ArthorH/MMS2-F405/PCB-source/IMG/PINOUT_ROWC.PNG

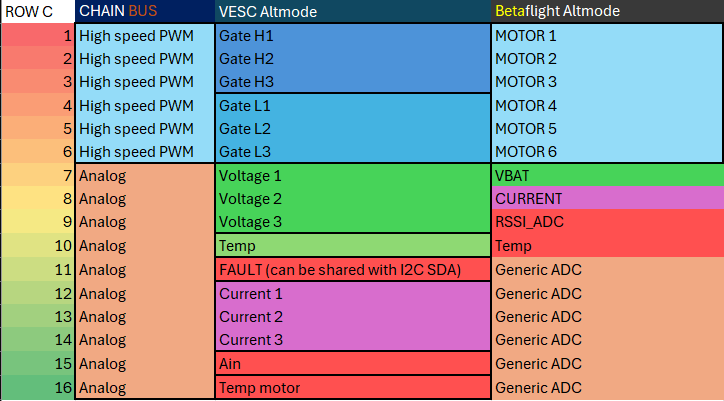
PCB-source/IMG/PINOUT_ROWC.PNG
