ArthorH/MMS2-F405/PCB-source/IMG/PINOUT_ROWA.PNG

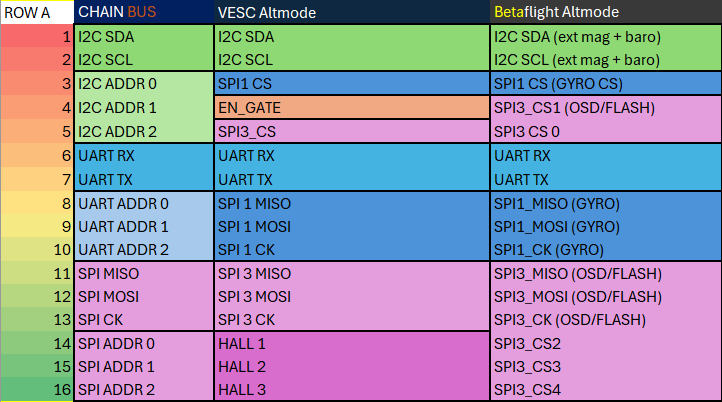
PCB-source/IMG/PINOUT_ROWA.PNG
