ArthorH/MMS2-F405/Doc/Chainbus-Pinout-Specification.xlsx

 | CHAINBUS CONNECTOR
ROW A IS DEDICATED FOR STACKABLE SOLUTION BUT ALSO CAN WORK IN ALTMODE |  |  |  |  |  |  | STM32F405RGT6 | STM32H563VGT6
ROW A pin | Num | CHAIN BUS | VESC Altmode | Betaflight Altmode | STM32F405RGT6 | STM32H563VGT6 | PA12
1 | 6 | UART RX | UART RX | UART RX | PC11 (UART4 RX) |  | PA11
2 | 7 | UART TX | UART TX | UART TX | PC10 (UART4 TX) |  | PB9
3 | 8 | UART ADDR 0 | SPI 1 MISO | SPI1_MISO (GYRO) | PA6 (SPI 1) (GPIO) |  | PB8
4 | 9 | UART ADDR 1 | SPI 1 MOSI | SPI1_MOSI (GYRO) | PA7 (SPI 1) (GPIO) |  | PB6
5 | 10 | UART ADDR 2 | SPI 1 CK | SPI1_CK (GYRO) | PA5 (SPI 1) (GPIO) |  | PB13
6 | 11 | SPI MISO | SPI 3 MISO | SPI3_MISO (OSD/FLASH) | PB4 (SPI3) (GPIO)
7 | 12 | SPI MOSI | SPI 3 MOSI | SPI3_MOSI (OSD/FLASH) | PC12 (SPI3) (GPIO)
8 | 13 | SPI CK | SPI 3 CK | SPI3_CK (OSD/FLASH) | PB3 (SPI3) (GPIO)
 | 14 | SPI ADDR 0 | HALL 1 | SPI3_CS2 | PC6 (SPI3_CS) (GPIO)
10 | 15 | SPI ADDR 1 | HALL 2 | SPI3_CS3 | PC7 (SPI3_CS) (GPIO)
11 | 16 | SPI ADDR 2 | HALL 3 | SPI3_CS4 | PC8 (SPI3_CS) (GPIO)
12 | 3 | I2C ADDR 0 | SPI1 CS | SPI1 CS (GYRO CS) | PA15 (SPI1_CS) (GPIO)
13 | 4 | I2C ADDR 1 | EN_GATE | SPI3_CS1 (OSD/FLASH) | PB5 (SPI3 CS) (EN)
14 | 5 | I2C ADDR 2 | SPI3_CS | SPI3 CS 0 | PC9 (SPI3 CS) (GPIO)
16 | 2 | I2C SCL | I2C SCL | I2C SCL (ext mag + baro) | PB10 (I2C 2)
15 | 1 | I2C SDA | I2C SDA | I2C SDA (ext mag + baro) | PB11 (I2C 2)
ROW C IS DEDICATED ALTMODE HEADER MOSTLY FOR ANALOG
ROW C pin | Num | CHAIN BUS | VESC Altmode | Betaflight Altmode | STM32F405RGT6 | STM32H563VGT6
1 | 1 | High speed PWM | Gate H1 | MOTOR 1 | PA8 (TIM CH)
2 | 2 | High speed PWM | Gate H2 | MOTOR 2 | PA9 (TIM CH)
3 | 3 | High speed PWM | Gate H3 | MOTOR 3 | PA10 (TIM CH)
4 | 4 | High speed PWM | Gate L1 | MOTOR 4 | PB13 (TIM CH)
5 | 5 | High speed PWM | Gate L2 | MOTOR 5 | PB14 (TIM CH)
6 | 6 | High speed PWM | Gate L3 | MOTOR 6 | PB15 (TIM CH)
7 | 11 | Analog | FAULT (can be shared with I2C SDA) | Generic ADC | PB7 (ADC IN)
8 | 12 | Analog | Current 1 | Generic ADC | PC0 (ADC IN)
9 | 13 | Analog | Current 2 | Generic ADC | PC1 (ADC IN)
10 | 14 | Analog | Current 3 | Generic ADC | PC2 (ADC IN)
11 | 15 | Analog | Ain | Generic ADC | PC3 (ADC IN)
12 | 7 | Analog | Voltage 1 | VBAT | PA0 (ADC IN)
13 | 8 | Analog | Voltage 2 | CURRENT | PA1 (ADC IN)
14 | 9 | Analog | Voltage 3 | RSSI_ADC | PA2 (ADC IN)
15 | 10 | Analog | Temp | Temp | PA3 (ADC IN)
16 | 16 | Analog | Temp motor | Generic ADC | PC4 (ADC IN)
 | ROW C IS DEDICATED ALTMODE HEADER MOSTLY FOR ANALOG
 | ROW B | MMS | Rating | Note | Powa
 | 1 | 3V3 | 1A max | MMS Output only | 3.3W
 | 2 | 5V | 1A max | MMS Output only | 5W
 | 3 | GND | 1A (5V and 3v3) return | Bidir | Return 8.3W
 | 4 | Vbat | 5v - 60v Vin | Bidir | 40W - 480W
 | 5 | Vbat | 5v - 60v Vin | Bidir
 | 6 | Vbat | 5v - 60v Vin | Bidir
 | 7 | Vbat | 5v - 60v Vin | Bidir
 | 8 | GND | 2A return | Bidir | Return 40W - 480W
 | 9 | GND | 2A return | Bidir
 | 10 | GND | 2A return | Bidir
 | 11 | GND | 2A return | Bidir
 | 12 | Reserved | N/A | N/A | N/A
 | 13 | Reserved | N/A | N/A | N/A
 | 14 | Reserved | N/A | N/A | N/A
 | 15 | Reserved | N/A | N/A | N/A
 | 16 | Reserved | N/A | N/A | N/A
VESC: — the VESC firmware uses the H1/H2/H3/L1/L2/L3 PWM channels and typical ADCs for current/vbat; AS5048 on SPI1 with PB3 CS is straightforward to configure in VESC (select the CS pin in hardware config).
Betaflight: once you resource-map the pins you chose (serial on PB11/PB10, SPI1 on PA5/6/7 with CS on PB3, SPI3 on PC10/11/12 with CS lines on PC9/PC6/PC7/PC8, motors on PA8/PA9/PA10/PB13-15, ADCs on PA0/1/2), Betaflight can be made to work. You will need to set resource commands.
