ArthorH/MMS2-F405/Doc/MMS2_QR.PNG

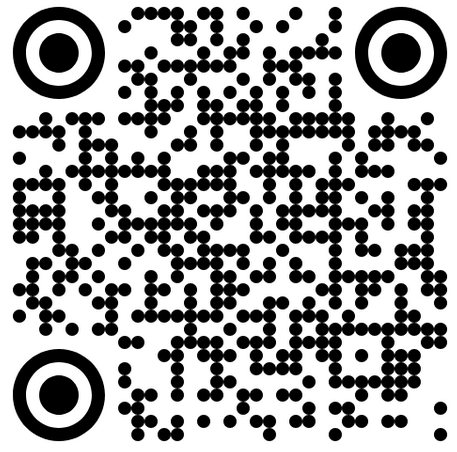
Doc/MMS2_QR.PNG
