ArthorH/MMS2-F405/PCB-source/IMG/999x999-product_41021_41021037_41021037-1.jpg

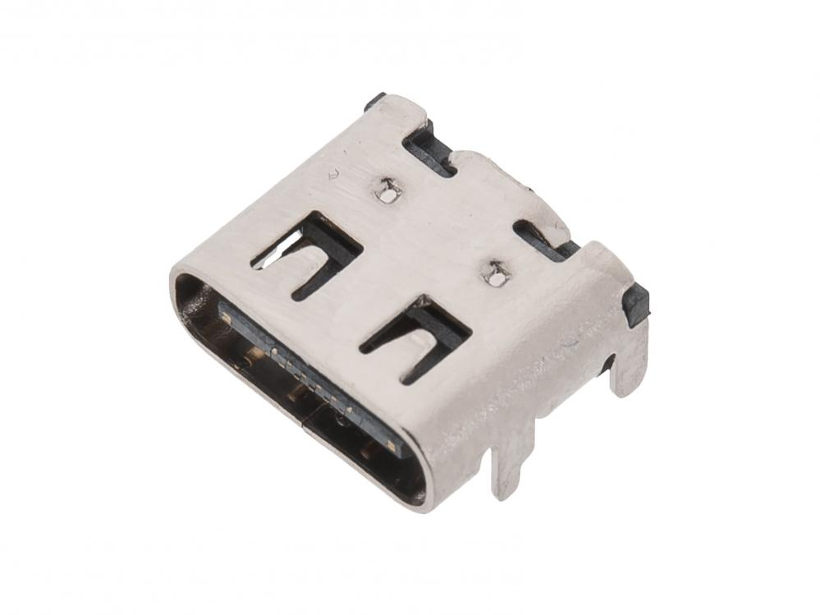
PCB-source/IMG/999x999-product_41021_41021037_41021037-1.jpg
