ArthorH/MMS2-F405/PCB-source/IMG/amass-XT60PW-M_l.jpg

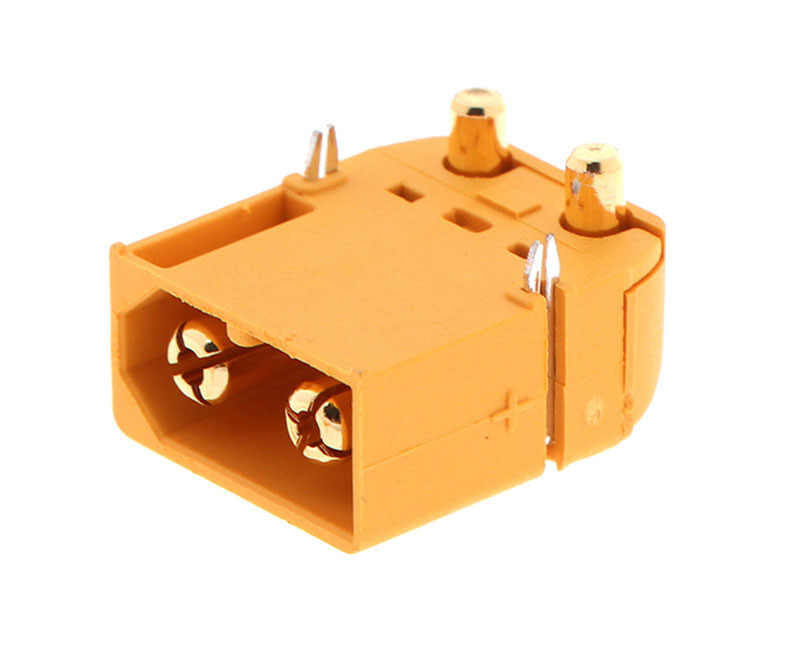
PCB-source/IMG/amass-XT60PW-M_l.jpg
