ArthorH/MMS2-F405/PCB-source/IMG/Capture.PNG

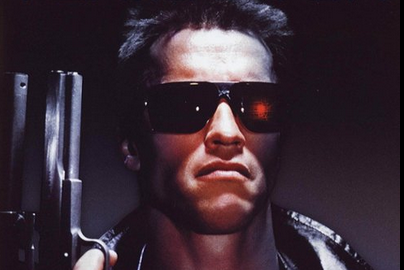
PCB-source/IMG/Capture.PNG
