ArthorH/MMS2-F405/PCB-source/IMG/images.jpg

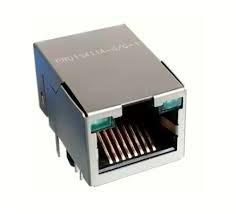
PCB-source/IMG/images.jpg
