ArthorH/MMS2-F405/PCB-source/IMG/Pcb spacer.PNG

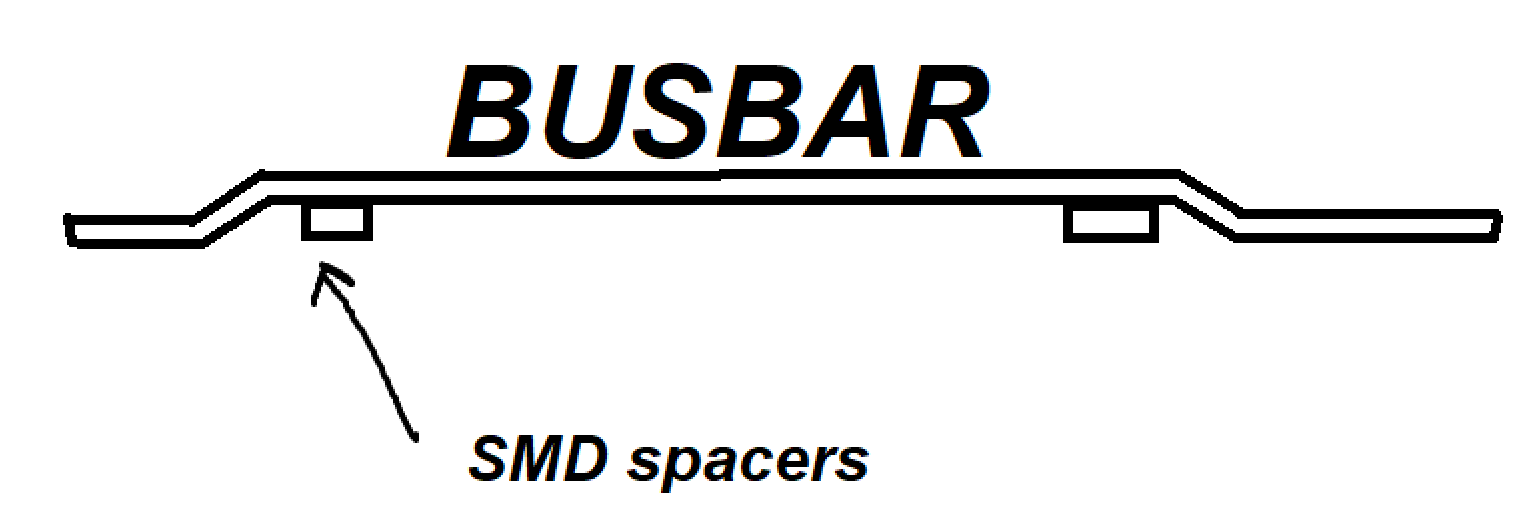
PCB-source/IMG/Pcb spacer.PNG
