ArthorH/MMS2-F405/PCB-source/IMG/USBimpedance.PNG

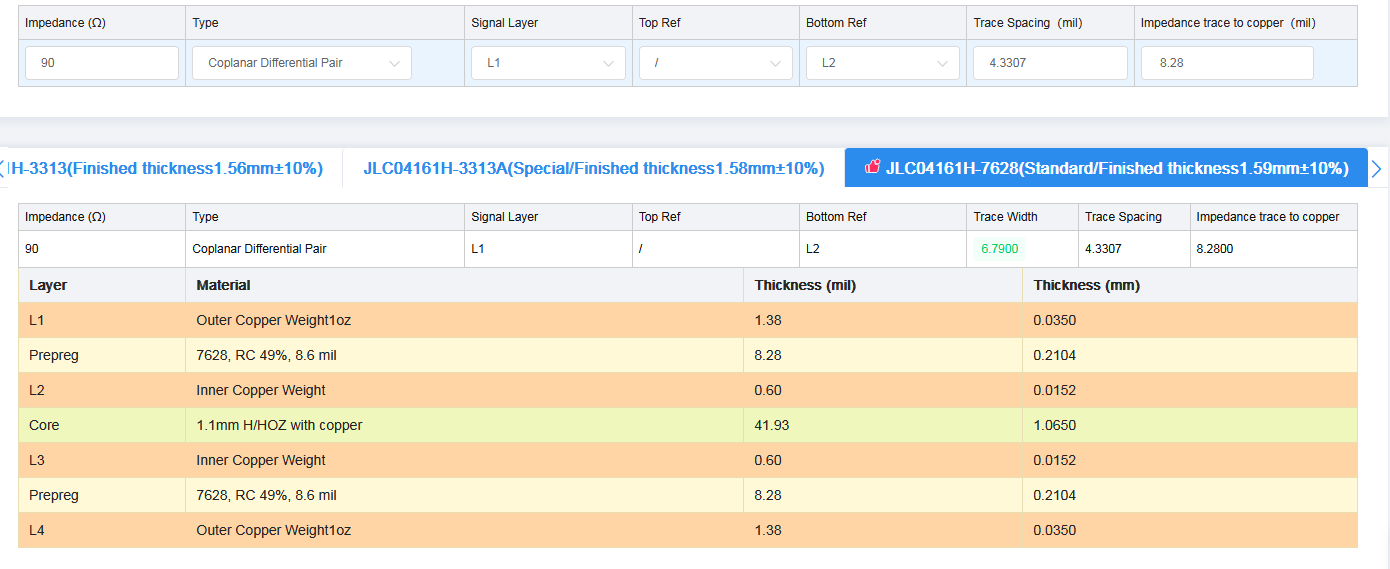
PCB-source/IMG/USBimpedance.PNG
