ArthorH/MMS2-F405/PCB-source/MMS2.kicad_pcb

## KiCad design PCB-source/MMS2.kicad_pcb (2025-09-29)

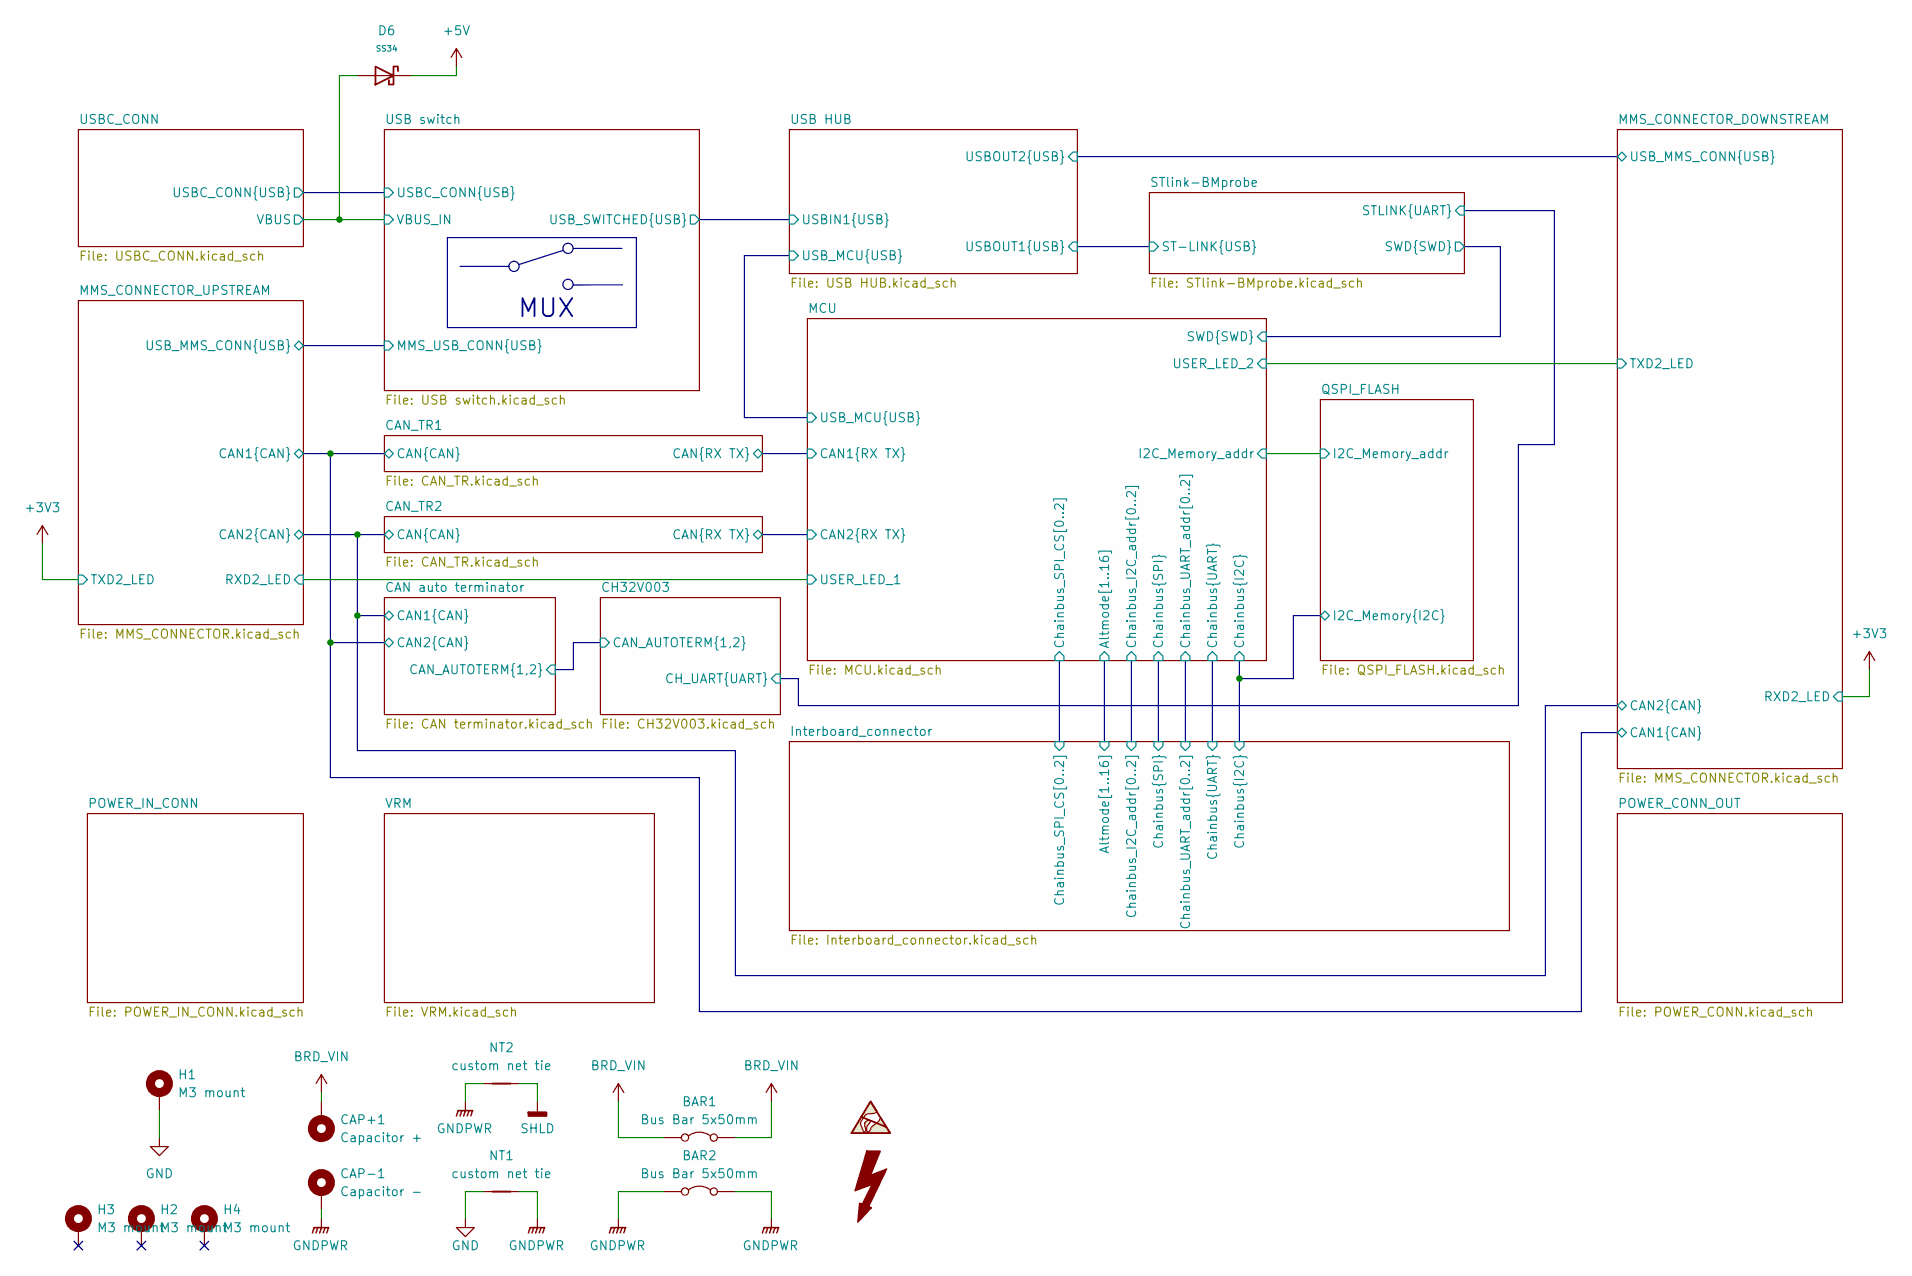
[picture p10: schematic MMS2.kicad_sch]

Parts:
BAR1: Bus Bar 5x50mm; BusBar-50mm-Red
BAR2: Bus Bar 5x50mm; BusBar-50mm-black
CAP+1: Capacitor +; TestPoint_THTPad_1.5x1.5mm_Drill0.7mm
CAP-1: Capacitor -; TestPoint_THTPad_1.5x1.5mm_Drill0.7mm
D6: SS34; D_SMA; Forward Voltage (Vf@If) 550mV@3A; Reverse Voltage (Vr) 40V; Part SS34; LCSC C8678
H1, H2: M3 mount; MountingHole_3.2mm_M3_DIN965_Pad
H3, H4: M3 mount; MountingHole_3.2mm_M3_DIN965_Pad; LCSC C49236535
NT1: custom net tie; Custom
NT2: custom net tie; SHLD

Connections:
+5V: D6.1; also elsewhere on the board
BRD_VIN: BAR1.1 (A), BAR1.2 (B), CAP+1.1; also elsewhere on the board
GND: H1.1, NT1.1; also elsewhere on the board
GNDPWR: BAR2.1 (A), BAR2.2 (B), CAP-1.1, NT1.2, NT2.1; also elsewhere on the board
SHLD: NT2.2
VBUS: D6.2; also elsewhere on the board

Notes on the sheet:
MUX

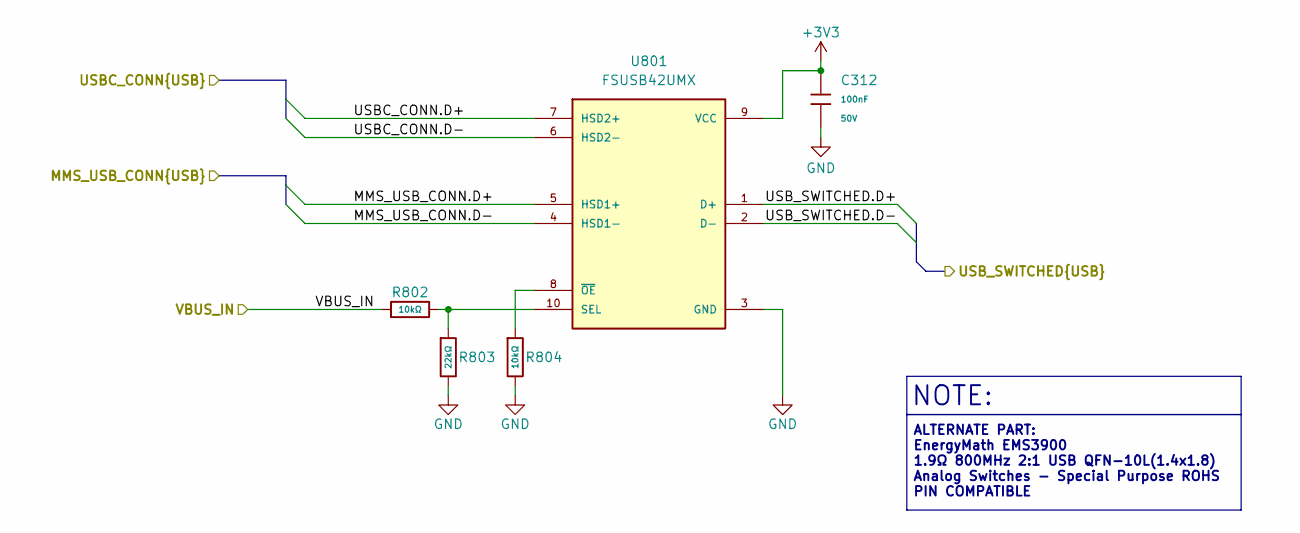
[picture p11: schematic USB switch.kicad_sch]

Parts:
C312: 100nF; C_0402; Voltage Rated 50V; Tolerance ±10%; Part CL05B104KB54PNC; LCSC C307331
R802, R804: 10kΩ; R_0402; Overload Voltage (Max) 50V; Tolerance ±1%; Part 0402WGF1002TCE; LCSC C25744
R803: 22kΩ; R_0402; Overload Voltage (Max) 50V; Tolerance ±1%; Part 0402WGF2202TCE; LCSC C25768
U801: FSUSB42UMX; UFQFN-10_1.4x1.8; PARTREV 1.25; LCSC C11145

Connections:
+3V3: C312.1, U801.9 (VCC); also elsewhere on the board
/MMS_CONNECTOR_UPSTREAM/USB_MMS_CONN.D+: U801.5 (HSD1+); also elsewhere on the board
/MMS_CONNECTOR_UPSTREAM/USB_MMS_CONN.D-: U801.4 (HSD1-); also elsewhere on the board
/USB HUB/USBIN1.D+: U801.1 (D+); also elsewhere on the board
/USB HUB/USBIN1.D-: U801.2 (D-); also elsewhere on the board
/USB switch/USBC_CONN.D+: U801.7 (HSD2+); also elsewhere on the board
/USB switch/USBC_CONN.D-: U801.6 (HSD2-); also elsewhere on the board
GND: C312.2, R803.2, R804.2, U801.3 (GND); also elsewhere on the board
unnamed: R802.2, R803.1, U801.10 (SEL)
unnamed: R804.1, U801.8 (~OE)
VBUS: R802.1; also elsewhere on the board

Notes on the sheet:
NOTE:
ALTERNATE PART: EnergyMath EMS3900 1.9Ω 800MHz 2:1 USB QFN-10L(1.4x1.8) Analog Switches - Special Purpose ROHS PIN COMPATIBLE

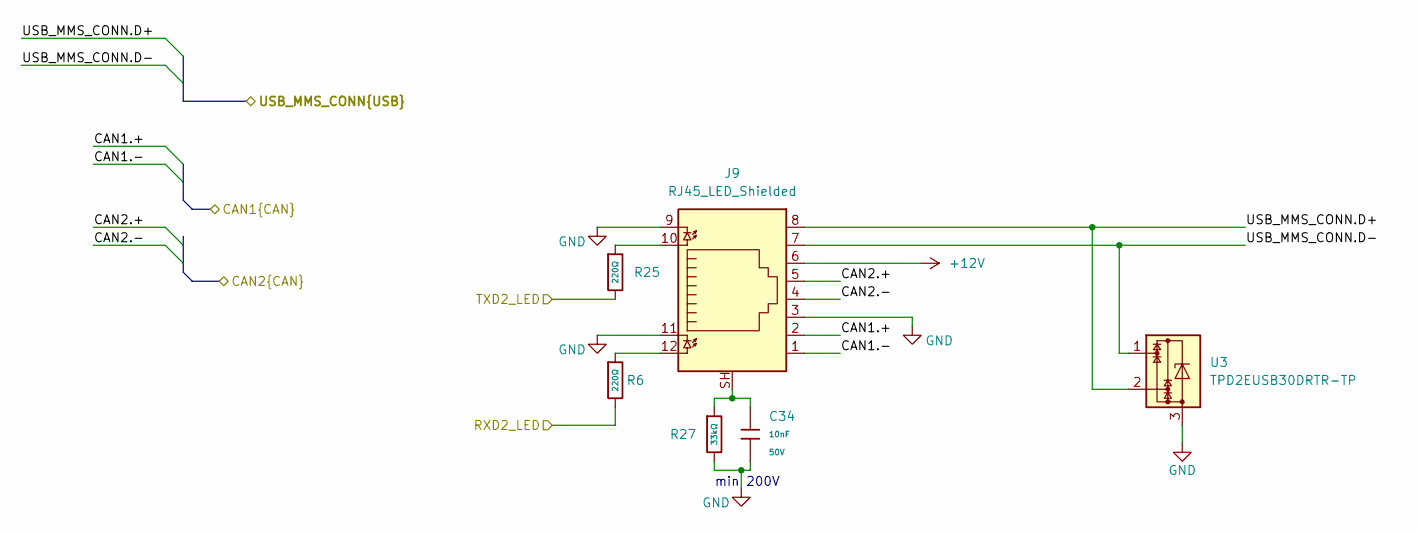
[picture p12: schematic MMS_CONNECTOR.kicad_sch, Mini moducard connector]

Parts:
C34: 10nF; C_0402; Voltage Rated 50V; Tolerance ±10%; Part CL05B103KB5NNNC; LCSC C15195
J9: RJ45_LED_Shielded; RJ45_Amphenol_RJHSE538X
R6, R25: 220Ω; R_0402; Overload Voltage (Max) 50V; Tolerance ±1%; Part 0402WGF2200TCE; LCSC C25091
R27: 33kΩ; R_0402; Overload Voltage (Max) 50V; Tolerance ±1%; Part 0402WGF3302TCE; LCSC C25779
U3: TPD2EUSB30DRTR-TP; SOT-723; LCSC C2844720

Connections:
+3V3: R6.2; also elsewhere on the board
+12V: J9.6; also elsewhere on the board
/CAN auto terminator/CAN1.+: J9.5; also elsewhere on the board
/CAN auto terminator/CAN1.-: J9.4; also elsewhere on the board
/CAN auto terminator/CAN2.+: J9.2; also elsewhere on the board
/CAN auto terminator/CAN2.-: J9.1; also elsewhere on the board
/MCU/USER_LED_2: R25.2; also elsewhere on the board
/MMS_CONNECTOR_DOWNSTREAM/USB_MMS_CONN.D+: J9.8, U3.2; also elsewhere on the board
/MMS_CONNECTOR_DOWNSTREAM/USB_MMS_CONN.D-: J9.7, U3.1; also elsewhere on the board
GND: C34.2, J9.3, J9.9, J9.11, R27.2, U3.3; also elsewhere on the board
unnamed: C34.1, J9.SH, R27.1
unnamed: J9.10, R25.1
unnamed: J9.12, R6.1

Parts of its further copies:
C45: 10nF; C_0402; Voltage Rated 50V; Tolerance ±10%; Part CL05B103KB5NNNC; LCSC C15195
J8: RJ45_LED_Shielded; RJ45_Amphenol_RJHSE538X
R26, R53: 220Ω; R_0402; Overload Voltage (Max) 50V; Tolerance ±1%; Part 0402WGF2200TCE; LCSC C25091
R51: 33kΩ; R_0402; Overload Voltage (Max) 50V; Tolerance ±1%; Part 0402WGF3302TCE; LCSC C25779
U4: TPD2EUSB30DRTR-TP; SOT-723; LCSC C2844720

Connections of its further copies:
+3V3: R26.2; also elsewhere on the board
+12V: J8.6; also elsewhere on the board
/CAN auto terminator/CAN1.+: J8.5; also elsewhere on the board
/CAN auto terminator/CAN1.-: J8.4; also elsewhere on the board
/CAN auto terminator/CAN2.+: J8.2; also elsewhere on the board
/CAN auto terminator/CAN2.-: J8.1; also elsewhere on the board
/MCU/USER_LED_1: R53.2; also elsewhere on the board
/MMS_CONNECTOR_UPSTREAM/USB_MMS_CONN.D+: J8.8, U4.2; also elsewhere on the board
/MMS_CONNECTOR_UPSTREAM/USB_MMS_CONN.D-: J8.7, U4.1; also elsewhere on the board
GND: C45.2, J8.3, J8.9, J8.11, R51.2, U4.3; also elsewhere on the board
unnamed: C45.1, J8.SH, R51.1
unnamed: J8.10, R26.1
unnamed: J8.12, R53.1

Notes on the sheet:
min 200V

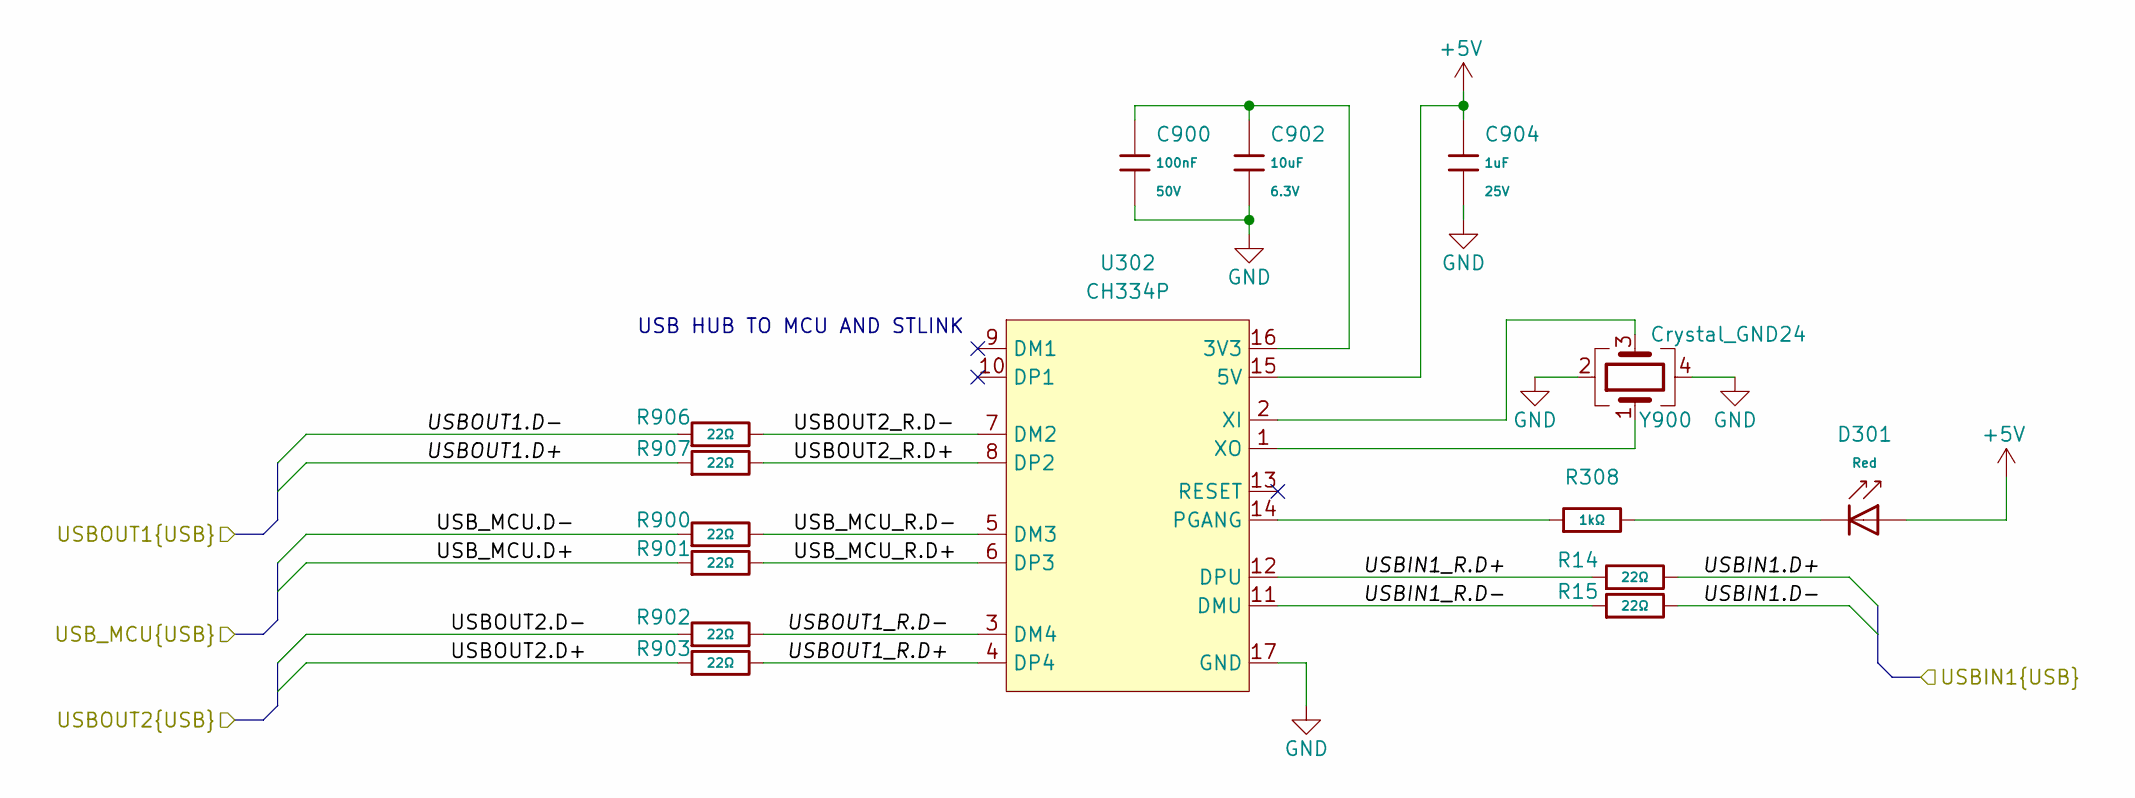
[picture p13: schematic USB HUB.kicad_sch, MMS2]

Parts:
C900: 100nF; C_0402; Voltage Rated 50V; Tolerance ±10%; Part CL05B104KB54PNC; LCSC C307331
C902: 10uF; C_0402; Voltage Rated 6.3V; Tolerance ±20%; Part CL05A106MQ5NUNC; LCSC C15525
C904: 1uF; C_0402; Voltage Rated 25V; Tolerance ±10%; Part CL05A105KA5NQNC; LCSC C52923
D301: Red; D_0603; Part KT-0603R; LCSC C2286
R14, R15, R900, R901, R902, R903, R906, R907: 22Ω; R_0402; Overload Voltage (Max) 50V; Tolerance ±1%; Part 0402WGF220JTCE; LCSC C25092
R308: 1kΩ; R_0402; Overload Voltage (Max) 50V; Tolerance ±1%; Part 0402WGF1001TCE; LCSC C11702
U302: CH334P; QFN-16-1EP_3x3mm_P0.5mm_EP1.7x1.7mm
Y900: Crystal_GND24; Crystal_SMD_3225-4Pin_3.2x2.5mm; LCSC C9002

Connections:
+5V: C904.1, D301.2, U302.15 (5V); also elsewhere on the board
/MCU/USB_MCU.D+: R901.1; also elsewhere on the board
/MCU/USB_MCU.D-: R900.1; also elsewhere on the board
/MMS_CONNECTOR_DOWNSTREAM/USB_MMS_CONN.D+: R903.1; also elsewhere on the board
/MMS_CONNECTOR_DOWNSTREAM/USB_MMS_CONN.D-: R902.1; also elsewhere on the board
/STlink-BMprobe/ST-LINK.D+: R907.1; also elsewhere on the board
/STlink-BMprobe/ST-LINK.D-: R906.1; also elsewhere on the board
/USB HUB/USBIN1.D+: R14.2; also elsewhere on the board
/USB HUB/USBIN1.D-: R15.2; also elsewhere on the board
/USB HUB/USBIN1_R.D+: R14.1, U302.12 (DPU)
/USB HUB/USBIN1_R.D-: R15.1, U302.11 (DMU)
/USB HUB/USBOUT1_R.D+: R903.2, U302.4 (DP4)
/USB HUB/USBOUT1_R.D-: R902.2, U302.3 (DM4)
/USB HUB/USBOUT2_R.D+: R907.2, U302.8 (DP2)
/USB HUB/USBOUT2_R.D-: R906.2, U302.7 (DM2)
/USB HUB/USB_MCU_R.D+: R901.2, U302.6 (DP3)
/USB HUB/USB_MCU_R.D-: R900.2, U302.5 (DM3)
GND: C900.2, C902.2, C904.2, U302.17 (GND), Y900.2, Y900.4; also elsewhere on the board
unnamed: D301.1, R308.2
unnamed: C900.1, C902.1, U302.16 (3V3)
unnamed: R308.1, U302.14 (PGANG)
unnamed: U302.2 (XI), Y900.3
unnamed: U302.1 (XO), Y900.1

Notes on the sheet:
USB HUB TO MCU AND STLINK

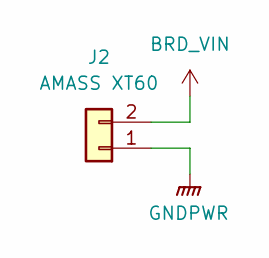
[picture p14: schematic POWER_IN_CONN.kicad_sch]

Parts:
J2: AMASS XT60; AMASS_XT60PW-M_1x02_P7.20mm_Horizontal; LCSC C98732

Connections:
BRD_VIN: J2.2; also elsewhere on the board
GNDPWR: J2.1; also elsewhere on the board

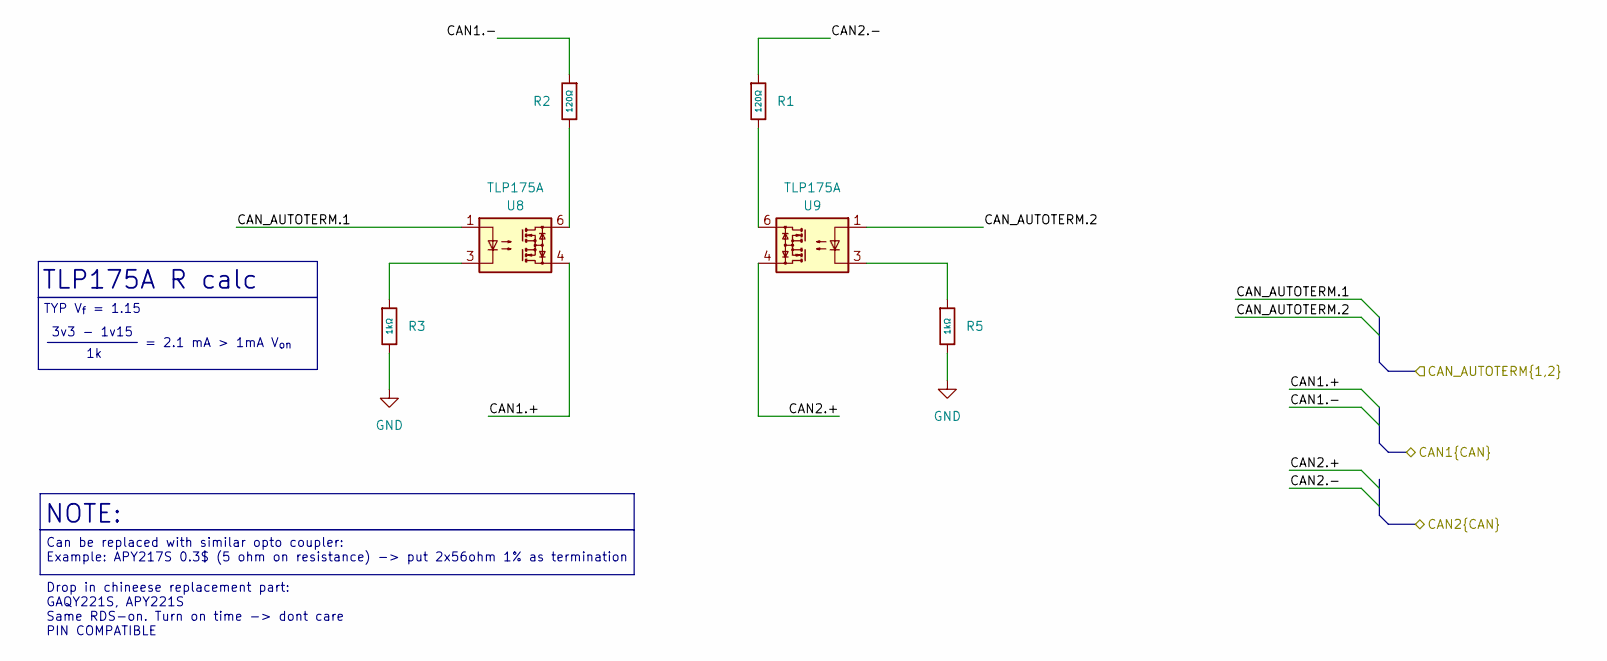
[picture p15: schematic CAN terminator.kicad_sch, CAN Auto terminator]

Parts:
R1, R2: 120Ω; R_0402; Overload Voltage (Max) 50V; Tolerance ±1%; Part 0402WGF1200TCE; LCSC C25079
R3, R5: 1kΩ; R_0402; Overload Voltage (Max) 50V; Tolerance ±1%; Part 0402WGF1001TCE; LCSC C11702
U8, U9: TLP175A; Toshiba_SOIC-4-6_4.4x3.6mm_P1.27mm; LCSC C141522

Connections:
/CAN auto terminator/CAN1.+: U8.4; also elsewhere on the board
/CAN auto terminator/CAN1.-: R2.1; also elsewhere on the board
/CAN auto terminator/CAN2.+: U9.4; also elsewhere on the board
/CAN auto terminator/CAN2.-: R1.1; also elsewhere on the board
/CAN auto terminator/CAN_AUTOTERM.1: U8.1; also elsewhere on the board
/CAN auto terminator/CAN_AUTOTERM.2: U9.1; also elsewhere on the board
GND: R3.2, R5.2; also elsewhere on the board
unnamed: R1.2, U9.6
unnamed: R2.2, U8.6
unnamed: R3.1, U8.3
unnamed: R5.1, U9.3

Notes on the sheet:
TYP V_{f} = 1.15
Can be replaced with similar opto coupler: Example: APY217S 0.3$ (5 ohm on resistance) -> put 2x56ohm 1% as termination
TLP175A R calc
3v3 - 1v15
Drop in chineese replacement part: GAQY221S, APY221S Same RDS-on. Turn on time -> dont care PIN COMPATIBLE
= 2.1 mA > 1mA V_{on}
NOTE:

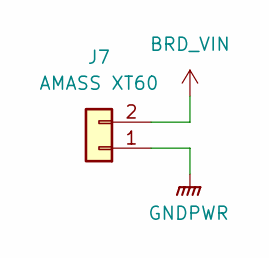
[picture p16: schematic POWER_CONN.kicad_sch, MMS2]

Parts:
J7: AMASS XT60; AMASS_XT60PW-F_1x02_P7.20mm_Horizontal; LCSC C428722

Connections:
BRD_VIN: J7.2; also elsewhere on the board
GNDPWR: J7.1; also elsewhere on the board

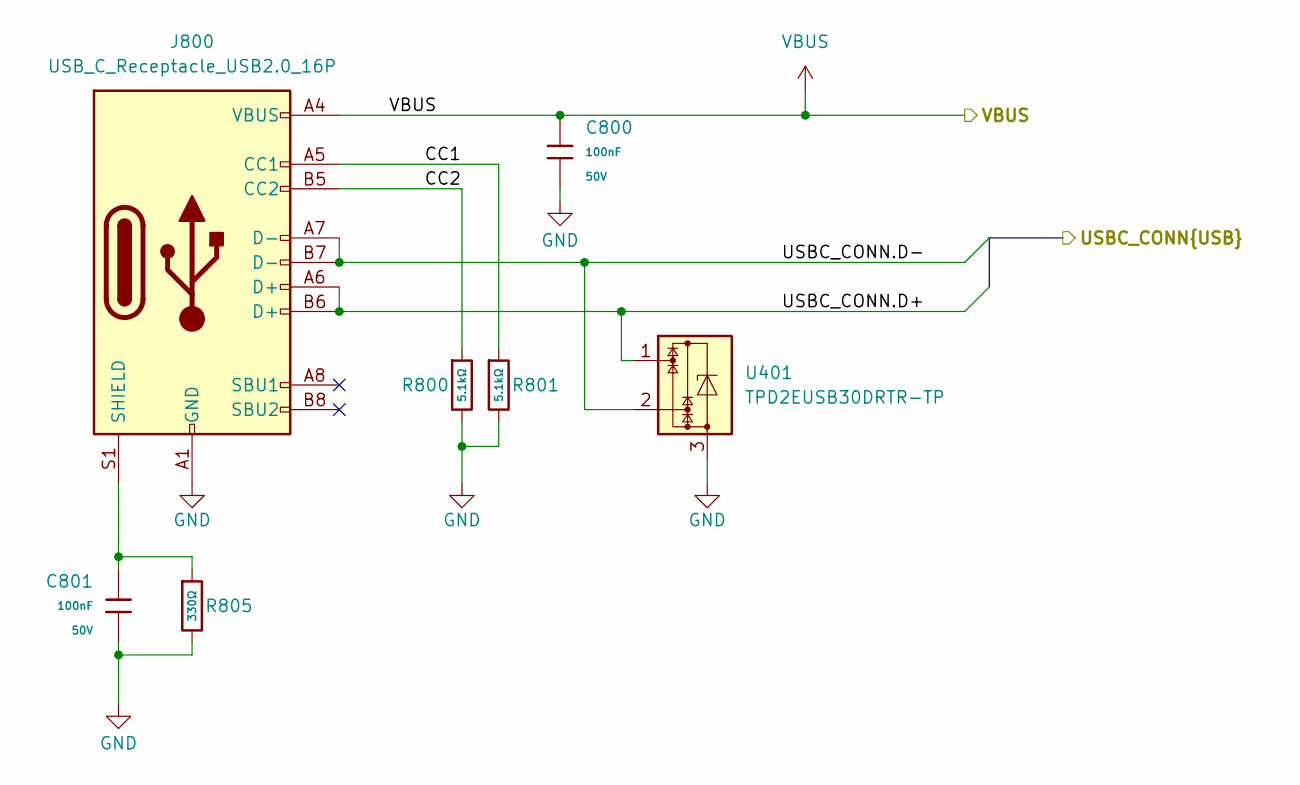
[picture p17: schematic USBC_CONN.kicad_sch, USB-C]

Parts:
C800, C801: 100nF; C_0402; Voltage Rated 50V; Tolerance ±10%; Part CL05B104KB54PNC; LCSC C307331
J800: USB_C_Receptacle_USB2.0_16P; USB_C_Receptacle_GCT_USB4105-xx-A_16P_TopMnt_Horizontal; LCSC C165948
R800, R801: 5.1kΩ; R_0402; Overload Voltage (Max) 50V; Tolerance ±1%; Part 0402WGF5101TCE; LCSC C25905
R805: 330Ω; R_0402; Overload Voltage (Max) 50V; Tolerance ±1%; Part 0402WGF3300TCE; LCSC C25104
U401: TPD2EUSB30DRTR-TP; SOT-723; LCSC C2844720

Connections:
/USB switch/USBC_CONN.D+: J800.A6 (D+), J800.B6 (D+), U401.1; also elsewhere on the board
/USB switch/USBC_CONN.D-: J800.A7 (D-), J800.B7 (D-), U401.2; also elsewhere on the board
/USBC_CONN/CC1: J800.A5 (CC1), R801.1
/USBC_CONN/CC2: J800.B5 (CC2), R800.1
GND: C800.2, C801.2, J800.A1 (GND), J800.A12 (GND), J800.B1 (GND), J800.B12 (GND), R800.2, R801.2, R805.2, U401.3; also elsewhere on the board
unnamed: C801.1, J800.S1 (SHIELD), R805.1
VBUS: C800.1, J800.A4 (VBUS), J800.A9 (VBUS), J800.B4 (VBUS), J800.B9 (VBUS); also elsewhere on the board

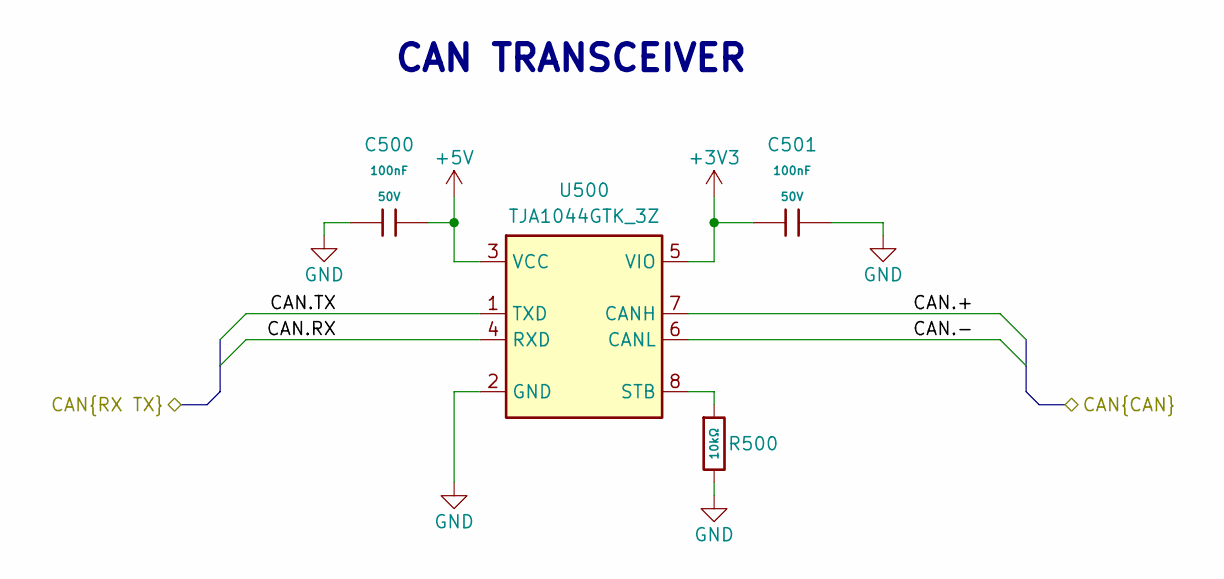
[picture p18: schematic CAN_TR.kicad_sch, CAN transceiver]

Parts:
C500, C501: 100nF; C_0402; Voltage Rated 50V; Tolerance ±10%; Part CL05B104KB54PNC; LCSC C307331
R500: 10kΩ; R_0402; Overload Voltage (Max) 50V; Tolerance ±1%; Part 0402WGF1002TCE; LCSC C25744
U500: TJA1044GTK_3Z; HVSON-8-1EP_3x3mm_P0.65mm_EP1.6x2.4mm; Manufacturer_Part_Number TJA1044GTK/3Z; LCSC C5215851

Connections:
+3V3: C501.1, U500.5 (VIO); also elsewhere on the board
+5V: C500.2, U500.3 (VCC); also elsewhere on the board
/CAN auto terminator/CAN2.+: U500.7 (CANH); also elsewhere on the board
/CAN auto terminator/CAN2.-: U500.6 (CANL); also elsewhere on the board
/CAN_TR1/CAN.RX: U500.4 (RXD); also elsewhere on the board
/CAN_TR1/CAN.TX: U500.1 (TXD); also elsewhere on the board
GND: C500.1, C501.2, R500.2, U500.2 (GND), U500.9 (EP); also elsewhere on the board
unnamed: R500.1, U500.8 (STB)

Parts of its further copies:
C502, C503: 100nF; C_0402; Voltage Rated 50V; Tolerance ±10%; Part CL05B104KB54PNC; LCSC C307331
R501: 10kΩ; R_0402; Overload Voltage (Max) 50V; Tolerance ±1%; Part 0402WGF1002TCE; LCSC C25744
U501: TJA1044GTK_3Z; HVSON-8-1EP_3x3mm_P0.65mm_EP1.6x2.4mm; Manufacturer_Part_Number TJA1044GTK/3Z; LCSC C5215851

Connections of its further copies:
+3V3: C503.1, U501.5 (VIO); also elsewhere on the board
+5V: C502.2, U501.3 (VCC); also elsewhere on the board
/CAN auto terminator/CAN1.+: U501.7 (CANH); also elsewhere on the board
/CAN auto terminator/CAN1.-: U501.6 (CANL); also elsewhere on the board
/CAN_TR2/CAN.RX: U501.4 (RXD); also elsewhere on the board
/CAN_TR2/CAN.TX: U501.1 (TXD); also elsewhere on the board
GND: C502.1, C503.2, R501.2, U501.2 (GND), U501.9 (EP); also elsewhere on the board
unnamed: R501.1, U501.8 (STB)

Notes on the sheet:
CAN TRANSCEIVER

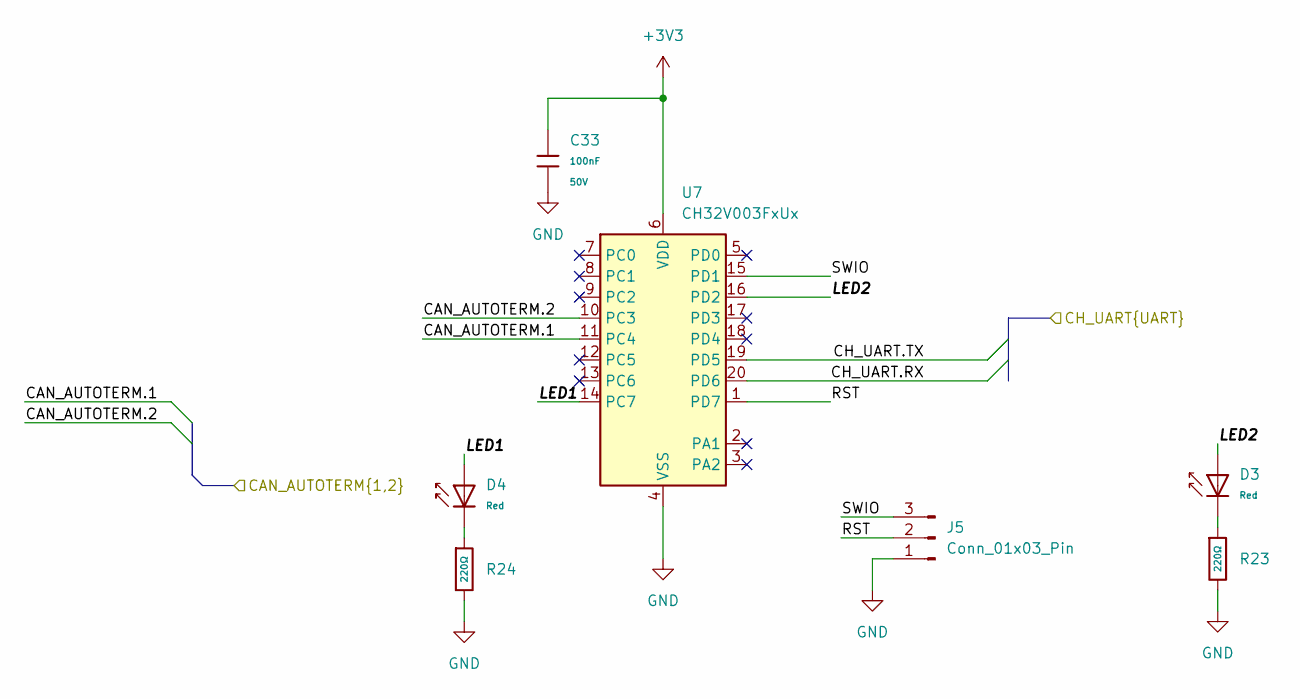
[picture p19: schematic CH32V003.kicad_sch]

Parts:
C33: 100nF; C_0402; Voltage Rated 50V; Tolerance ±10%; Part CL05B104KB54PNC; LCSC C307331
D3, D4: Red; D_0603; Part KT-0603R; LCSC C2286
J5: Conn_01x03_Pin; PinHeader_1x03_P1.27mm_Vertical
R23, R24: 220Ω; R_0402; Overload Voltage (Max) 50V; Tolerance ±1%; Part 0402WGF2200TCE; LCSC C25091
U7: CH32V003FxUx; QFN-20-1EP_3x3mm_P0.4mm_EP1.65x1.65mm; LCSC C5299908

Connections:
+3V3: C33.1, U7.6 (VDD); also elsewhere on the board
/CAN auto terminator/CAN_AUTOTERM.1: U7.11 (PC4); also elsewhere on the board
/CAN auto terminator/CAN_AUTOTERM.2: U7.10 (PC3); also elsewhere on the board
/CH32V003/CH_UART.RX: U7.20 (PD6); also elsewhere on the board
/CH32V003/CH_UART.TX: U7.19 (PD5); also elsewhere on the board
/CH32V003/LED1: D4.2, U7.14 (PC7)
/CH32V003/LED2: D3.2, U7.16 (PD2)
/CH32V003/RST: J5.2, U7.1 (PD7)
/CH32V003/SWIO: J5.3, U7.15 (PD1)
GND: C33.2, J5.1, R23.2, R24.2, U7.4 (VSS), U7.21 (VSS); also elsewhere on the board
unnamed: D3.1, R23.1
unnamed: D4.1, R24.1

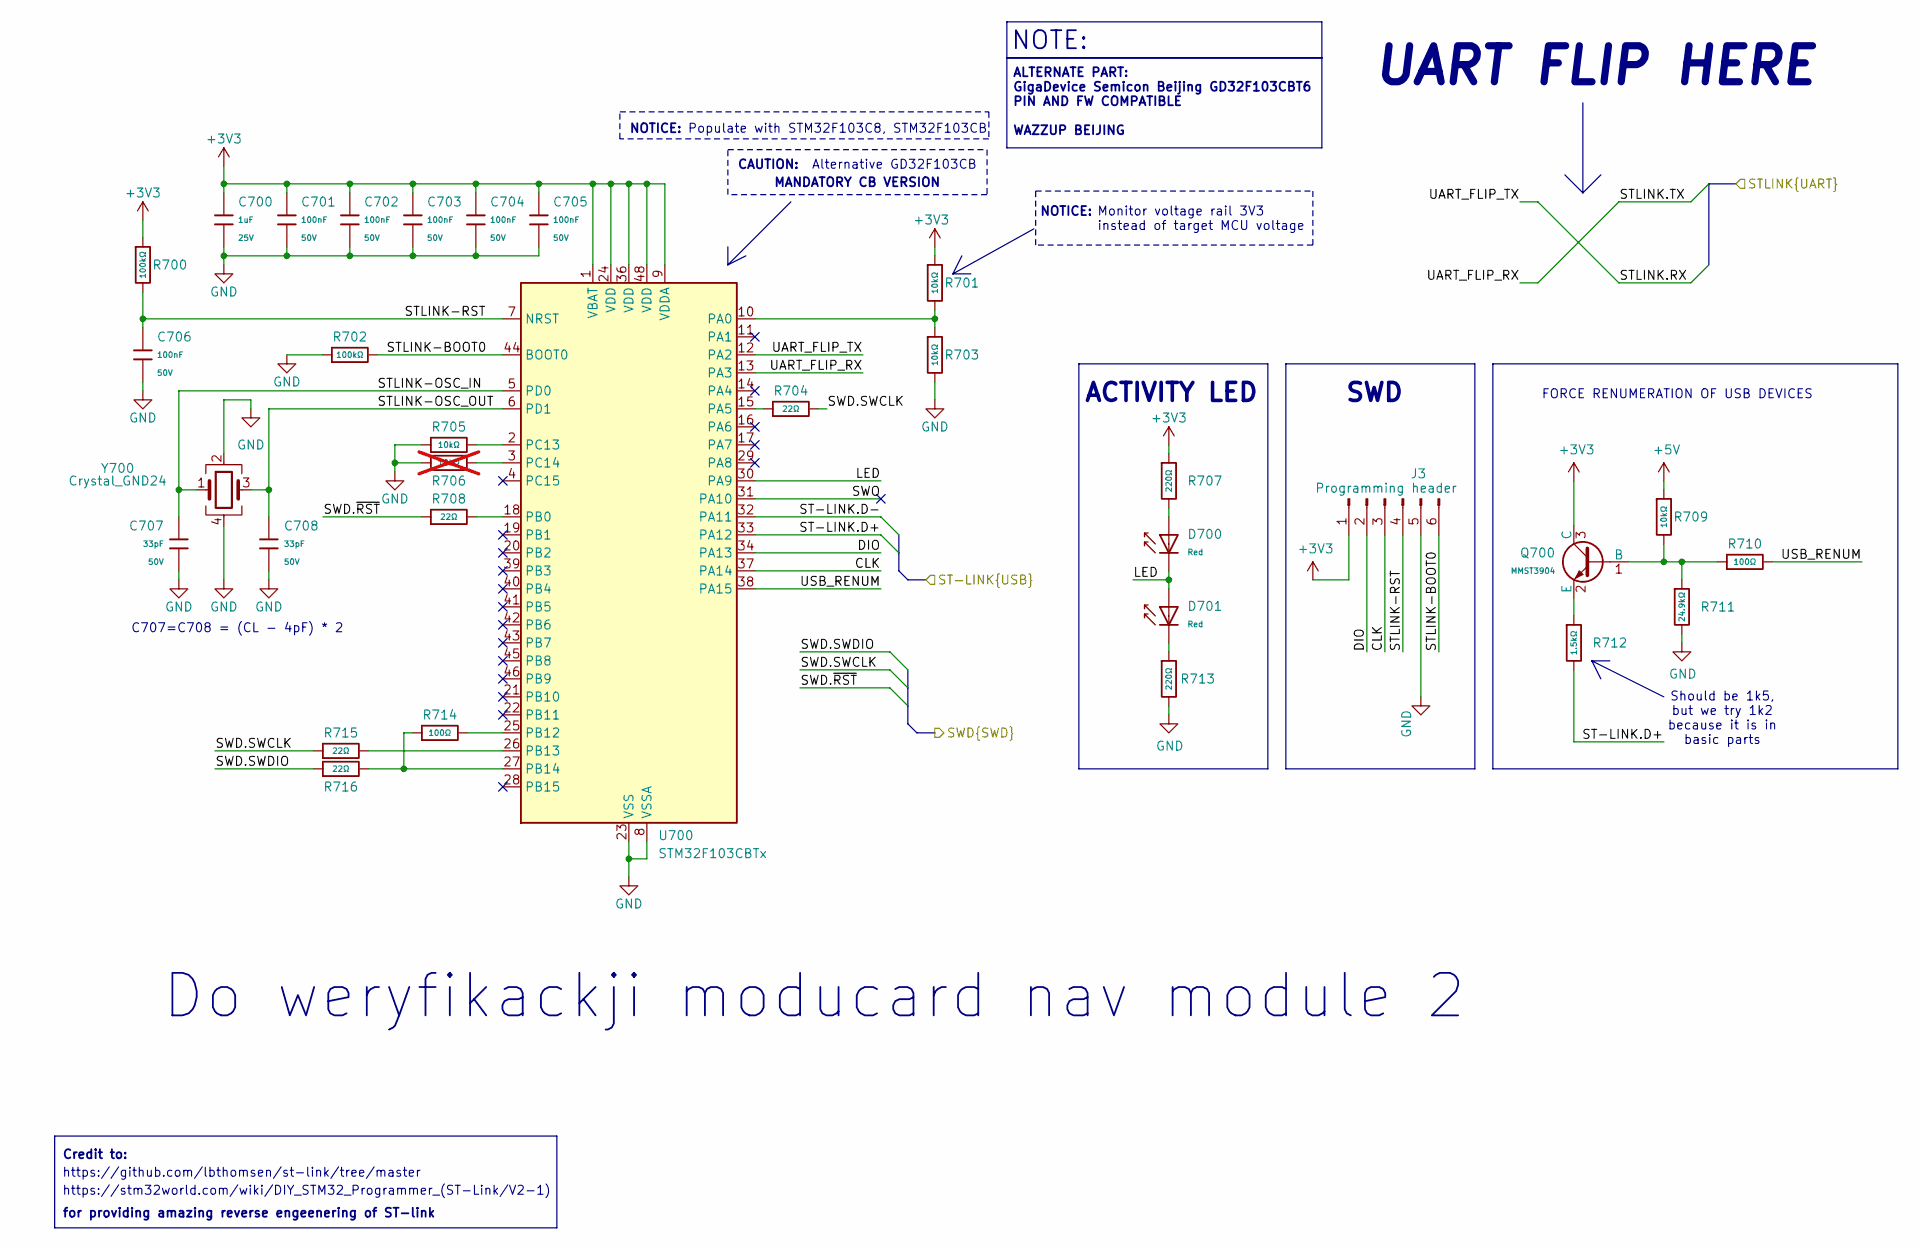
[picture p20: schematic STlink-BMprobe.kicad_sch, Black magic probe]

Parts:
C700: 1uF; C_0402; Voltage Rated 25V; Tolerance ±10%; Part CL05A105KA5NQNC; LCSC C52923
C701, C702, C703, C704, C705, C706: 100nF; C_0402; Voltage Rated 50V; Tolerance ±10%; Part CL05B104KB54PNC; LCSC C307331
C707, C708: 33pF; C_0402; Voltage Rated 50V; Tolerance ±5%; Part 0402CG330J500NT; LCSC C1562
D700, D701: Red; D_0603; Part KT-0603R; LCSC C2286
J3: Programming header; PinHeader_1x06_P1.27mm_Vertical
Q700: MMST3904; SOT-23; Part MMST3904; LCSC C20526
R700, R702: 100kΩ; R_0402; Overload Voltage (Max) 50V; Tolerance ±1%; Part 0402WGF1003TCE; LCSC C25741
R701, R703, R705, R709: 10kΩ; R_0402; Overload Voltage (Max) 50V; Tolerance ±1%; Part 0402WGF1002TCE; LCSC C25744
R704, R708, R715, R716: 22Ω; R_0402; Overload Voltage (Max) 50V; Tolerance ±1%; Part 0402WGF220JTCE; LCSC C25092
R706: 10kΩ; R_0402; Overload Voltage (Max) 50V; Tolerance ±1%; Part 0402WGF1002TCE; LCSC C25744; not fitted
R707, R713: 220Ω; R_0402; Overload Voltage (Max) 50V; Tolerance ±1%; Part 0402WGF2200TCE; LCSC C25091
R710, R714: 100Ω; R_0402; Overload Voltage (Max) 50V; Tolerance ±1%; Part 0402WGF1000TCE; LCSC C25076
R711: 24.9kΩ; R_0402; Overload Voltage (Max) 50V; Tolerance ±1%; Part 0402WGF2402TCE; LCSC C25874
R712: 1.5kΩ; R_0402; Overload Voltage (Max) 50V; Tolerance ±1%; Part 0402WGF1501TCE; LCSC C25867
U700: STM32F103CBTx; LQFP-48_7x7mm_P0.5mm; LCSC C8304
Y700: Crystal_GND24; CRYSTAL-SMD_4P-L3.2-W2.5-BL; MPN 3225-8.00-20-10-10/4B; LCSC C7424755

Connections:
+3V3: C700.1, C701.1, C702.1, C703.1, C704.1, C705.1, J3.1, Q700.3 (C), R700.1, R701.1, R707.1, U700.1 (VBAT), U700.9 (VDDA), U700.24 (VDD), U700.36 (VDD), U700.48 (VDD); also elsewhere on the board
+5V: R709.1; also elsewhere on the board
/CH32V003/CH_UART.RX: U700.12 (PA2); also elsewhere on the board
/CH32V003/CH_UART.TX: U700.13 (PA3); also elsewhere on the board
/MCU/SWD.SWCLK: R704.2, R715.1; also elsewhere on the board
/MCU/SWD.SWDIO: R716.1; also elsewhere on the board
/MCU/SWD.~RST: R708.1; also elsewhere on the board
/STlink-BMprobe/CLK: J3.3, U700.37 (PA14)
/STlink-BMprobe/DIO: J3.2, U700.34 (PA13)
/STlink-BMprobe/LED: D700.1, D701.2, U700.30 (PA9)
/STlink-BMprobe/ST-LINK.D+: R712.2, U700.33 (PA12); also elsewhere on the board
/STlink-BMprobe/ST-LINK.D-: U700.32 (PA11); also elsewhere on the board
/STlink-BMprobe/STLINK-BOOT0: J3.6, R702.2, U700.44 (BOOT0)
/STlink-BMprobe/STLINK-OSC_IN: C707.1, U700.5 (PD0), Y700.1
/STlink-BMprobe/STLINK-OSC_OUT: C708.1, U700.6 (PD1), Y700.3
/STlink-BMprobe/STLINK-RST: C706.1, J3.4, R700.2, U700.7 (NRST)
/STlink-BMprobe/SWO: U700.31 (PA10)
/STlink-BMprobe/USB_RENUM: R710.2, U700.38 (PA15)
GND: C700.2, C701.2, C702.2, C703.2, C704.2, C705.2, C706.2, C707.2, C708.2, J3.5, R702.1, R703.2, R705.1, R706.1, R711.2, R713.2, U700.8 (VSSA), U700.23 (VSS), U700.35 (VSS), U700.47 (VSS), Y700.2, Y700.4; also elsewhere on the board
unnamed: D700.2, R707.2
unnamed: D701.1, R713.1
unnamed: Q700.1 (B), R709.2, R710.1, R711.1
unnamed: Q700.2 (E), R712.1
unnamed: R701.2, R703.1, U700.10 (PA0)
unnamed: R704.1, U700.15 (PA5)
unnamed: R708.2, U700.18 (PB0)
unnamed: R714.2, U700.25 (PB12)
unnamed: R715.2, U700.26 (PB13)
unnamed: R714.1, R716.2, U700.27 (PB14)
unnamed: R705.2, U700.2 (PC13)
unnamed: R706.2, U700.3 (PC14)

Notes on the sheet:
ACTIVITY LED
NOTICE:
Alternative GD32F103CB
FORCE RENUMERATION OF USB DEVICES
for providing amazing reverse engeenering of ST-link
Monitor voltage rail 3V3 instead of target MCU voltage
UART FLIP HERE
https://github.com/lbthomsen/st-link/tree/master
SWD
NOTE:
MANDATORY CB VERSION
CAUTION:
Credit to:
https://stm32world.com/wiki/DIY_STM32_Programmer_(ST-Link/V2-1)
ALTERNATE PART: GigaDevice Semicon Beijing GD32F103CBT6 PIN AND FW COMPATIBLE WAZZUP BEIJING
Populate with STM32F103C8, STM32F103CB
Should be 1k5, but we try 1k2 because it is in basic parts
Do weryfikackji moducard nav module 2
C707=C708 = (CL - 4pF) * 2
