ArthorH/MMS2-F405/PCB-source/MMS2.kicad_pcb

## KiCad design PCB-source/MMS2.kicad_pcb (continued)

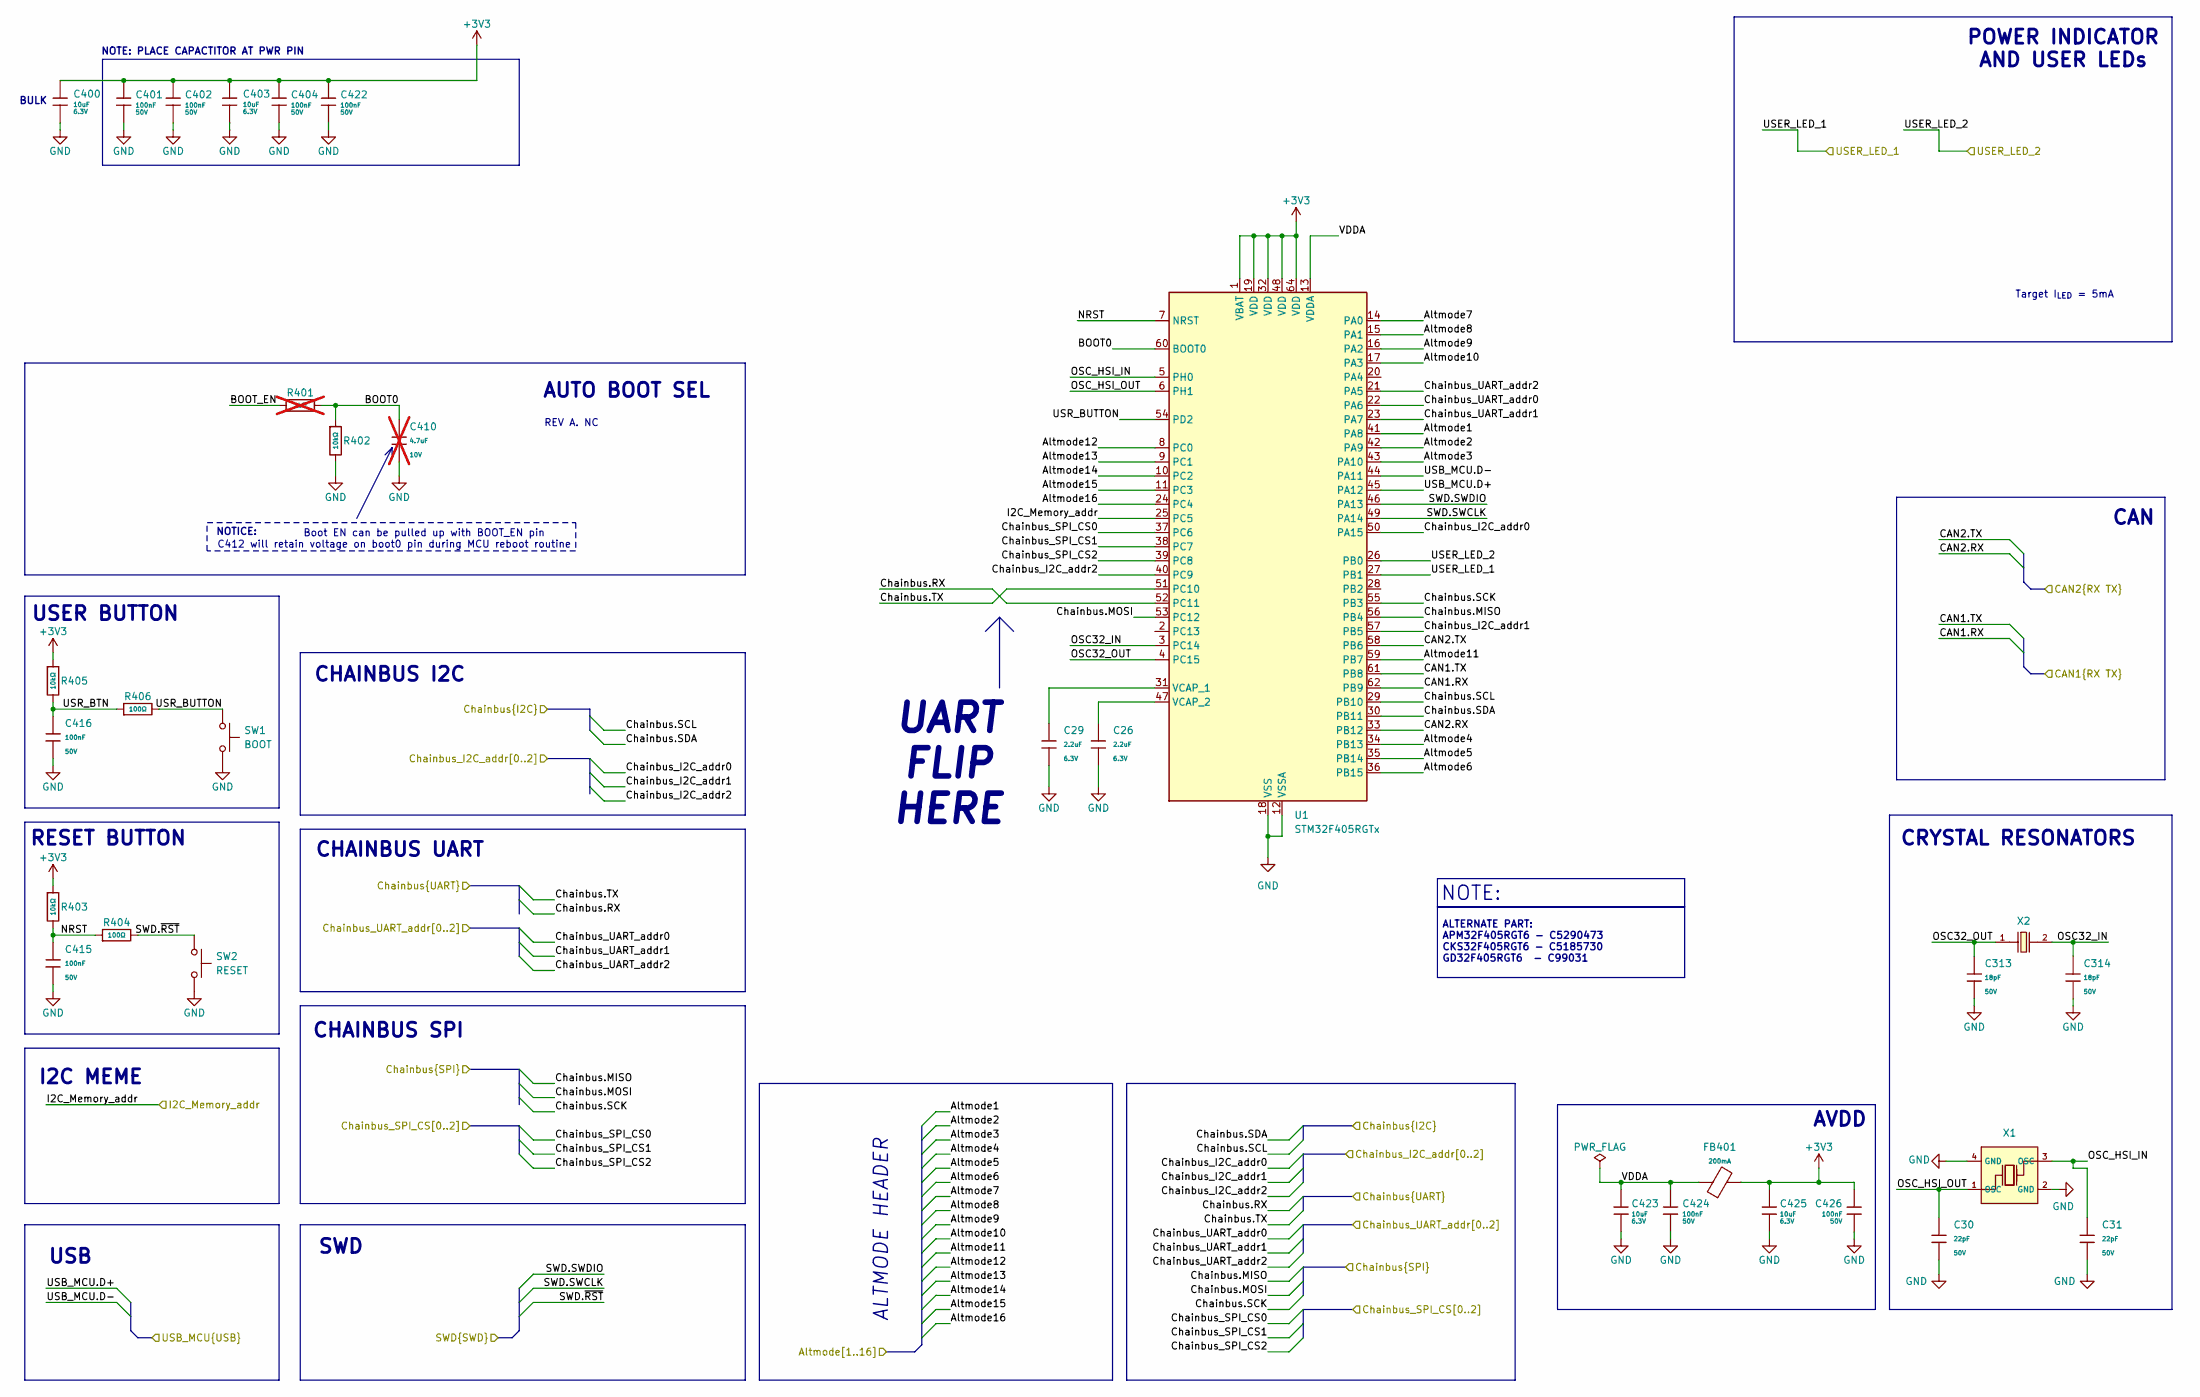
[picture p21: schematic MCU.kicad_sch, MMS2]

Parts:
C26, C29: 2.2uF; C_0402; Voltage Rated 6.3V; Tolerance ±20%; Part CL05A225MQ5NSNC; LCSC C12530
C30, C31: 22pF; C_0402; Voltage Rated 50V; Tolerance ±5%; Part 0402CG220J500NT; LCSC C1555
C313, C314: 18pF; C_0402; Voltage Rated 50V; Tolerance ±5%; Part 0402CG180J500NT; LCSC C1549
C400, C403, C423, C425: 10uF; C_0402; Voltage Rated 6.3V; Tolerance ±20%; Part CL05A106MQ5NUNC; LCSC C15525
C401, C402, C404, C415, C416, C422, C424, C426: 100nF; C_0402; Voltage Rated 50V; Tolerance ±10%; Part CL05B104KB54PNC; LCSC C307331
C410: 4.7uF; C_0402; Voltage Rated 10V; Tolerance ±20%; Part CL05A475MP5NRNC; LCSC C23733; not fitted
FB401: FB_0603; Current Rating 200mA; Tolerance ±25%; Part GZ1608D601TF; LCSC C1002
R401: 1kΩ; R_0402; Overload Voltage (Max) 50V; Tolerance ±1%; Part 0402WGF1001TCE; LCSC C11702; not fitted
R402, R403, R405: 10kΩ; R_0402; Overload Voltage (Max) 50V; Tolerance ±1%; Part 0402WGF1002TCE; LCSC C25744
R404, R406: 100Ω; R_0402; Overload Voltage (Max) 50V; Tolerance ±1%; Part 0402WGF1000TCE; LCSC C25076
SW1: BOOT; SW_Tactile_SPST_NO_Straight_CK_PTS636Sx25SMTRLFS; MPN TSB008A2530A; LCSC C22375371
SW2: RESET; SW_Tactile_SPST_NO_Straight_CK_PTS636Sx25SMTRLFS; MPN TSB008A2530A; LCSC C22375371
U1: STM32F405RGTx; LQFP-64_10x10mm_P0.5mm; LCSC C15742
X1: X32258MOB4SI; OSC-SMD_4P-L3.2-W2.5-BL; Frequency Tolerance ±10ppm; Part X322525MOB4SI; LCSC C2682775
X2: Q13FC1350000400; FC-135R_L3.2-W1.5; Frequency Tolerance ±20ppm; Part Q13FC13500004; LCSC C97606

Connections:
+3V3: C400.1, C401.1, C402.1, C403.1, C404.1, C422.1, C425.1, C426.1, FB401.2, R403.1, R405.1, U1.1 (VBAT), U1.19 (VDD), U1.32 (VDD), U1.48 (VDD), U1.64 (VDD); also elsewhere on the board
/CAN_TR1/CAN.RX: U1.62 (PB9); also elsewhere on the board
/CAN_TR1/CAN.TX: U1.61 (PB8); also elsewhere on the board
/CAN_TR2/CAN.RX: U1.33 (PB12); also elsewhere on the board
/CAN_TR2/CAN.TX: U1.58 (PB6); also elsewhere on the board
/Interboard_connector/Altmode1: U1.41 (PA8); also elsewhere on the board
/Interboard_connector/Altmode2: U1.42 (PA9); also elsewhere on the board
/Interboard_connector/Altmode3: U1.43 (PA10); also elsewhere on the board
/Interboard_connector/Altmode4: U1.34 (PB13); also elsewhere on the board
/Interboard_connector/Altmode5: U1.35 (PB14); also elsewhere on the board
/Interboard_connector/Altmode6: U1.36 (PB15); also elsewhere on the board
/Interboard_connector/Altmode7: U1.14 (PA0); also elsewhere on the board
/Interboard_connector/Altmode8: U1.15 (PA1); also elsewhere on the board
/Interboard_connector/Altmode9: U1.16 (PA2); also elsewhere on the board
/Interboard_connector/Altmode10: U1.17 (PA3); also elsewhere on the board
/Interboard_connector/Altmode11: U1.59 (PB7); also elsewhere on the board
/Interboard_connector/Altmode12: U1.8 (PC0); also elsewhere on the board
/Interboard_connector/Altmode13: U1.9 (PC1); also elsewhere on the board
/Interboard_connector/Altmode14: U1.10 (PC2); also elsewhere on the board
/Interboard_connector/Altmode15: U1.11 (PC3); also elsewhere on the board
/Interboard_connector/Altmode16: U1.24 (PC4); also elsewhere on the board
/Interboard_connector/Chainbus.MISO: U1.56 (PB4); also elsewhere on the board
/Interboard_connector/Chainbus.MOSI: U1.53 (PC12); also elsewhere on the board
/Interboard_connector/Chainbus.RX: U1.52 (PC11); also elsewhere on the board
/Interboard_connector/Chainbus.SCK: U1.55 (PB3); also elsewhere on the board
/Interboard_connector/Chainbus.SCL: U1.29 (PB10); also elsewhere on the board
/Interboard_connector/Chainbus.SDA: U1.30 (PB11); also elsewhere on the board
/Interboard_connector/Chainbus.TX: U1.51 (PC10); also elsewhere on the board
/Interboard_connector/Chainbus_I2C_addr0: U1.50 (PA15); also elsewhere on the board
/Interboard_connector/Chainbus_I2C_addr1: U1.57 (PB5); also elsewhere on the board
/Interboard_connector/Chainbus_I2C_addr2: U1.40 (PC9); also elsewhere on the board
/Interboard_connector/Chainbus_SPI_CS0: U1.37 (PC6); also elsewhere on the board
/Interboard_connector/Chainbus_SPI_CS1: U1.38 (PC7); also elsewhere on the board
/Interboard_connector/Chainbus_SPI_CS2: U1.39 (PC8); also elsewhere on the board
/Interboard_connector/Chainbus_UART_addr0: U1.22 (PA6); also elsewhere on the board
/Interboard_connector/Chainbus_UART_addr1: U1.23 (PA7); also elsewhere on the board
/Interboard_connector/Chainbus_UART_addr2: U1.21 (PA5); also elsewhere on the board
/MCU/BOOT0: C410.1, R401.2, R402.1, U1.60 (BOOT0)
/MCU/BOOT_EN: R401.1
/MCU/I2C_Memory_addr: U1.25 (PC5); also elsewhere on the board
/MCU/NRST: C415.1, R403.2, R404.1, U1.7 (NRST)
/MCU/OSC32_IN: C314.1, U1.3 (PC14), X2.2
/MCU/OSC32_OUT: C313.1, U1.4 (PC15), X2.1
/MCU/OSC_HSI_IN: C31.1, U1.5 (PH0), X1.3 (OSC)
/MCU/OSC_HSI_OUT: C30.1, U1.6 (PH1), X1.1 (OSC)
/MCU/SWD.SWCLK: U1.49 (PA14); also elsewhere on the board
/MCU/SWD.SWDIO: U1.46 (PA13); also elsewhere on the board
/MCU/SWD.~RST: R404.2, SW2.1; also elsewhere on the board
/MCU/USB_MCU.D+: U1.45 (PA12); also elsewhere on the board
/MCU/USB_MCU.D-: U1.44 (PA11); also elsewhere on the board
/MCU/USER_LED_1: U1.27 (PB1); also elsewhere on the board
/MCU/USER_LED_2: U1.26 (PB0); also elsewhere on the board
/MCU/USR_BTN: C416.1, R405.2, R406.1
/MCU/USR_BUTTON: R406.2, SW1.1, U1.54 (PD2)
/MCU/VDDA: C423.1, C424.1, FB401.1, U1.13 (VDDA)
GND: C26.2, C29.2, C30.2, C31.2, C313.2, C314.2, C400.2, C401.2, C402.2, C403.2, C404.2, C410.2, C415.2, C416.2, C422.2, C423.2, C424.2, C425.2, C426.2, R402.2, SW1.2, SW2.2, U1.12 (VSSA), U1.18 (VSS), U1.63 (VSS), X1.2 (GND), X1.4 (GND); also elsewhere on the board
unnamed: C29.1, U1.31 (VCAP_1)
unnamed: C26.1, U1.47 (VCAP_2)

Notes on the sheet:
UART FLIP HERE
NOTICE:
SWD
NOTE:
CHAINBUS UART
NOTE: PLACE CAPACTITOR AT PWR PIN
I2C MEME
Target I_{LED} = 5mA
CHAINBUS SPI
Boot EN can be pulled up with BOOT_EN pin C412 will retain voltage on boot0 pin during MCU reboot routine
ALTMODE HEADER
AVDD
AUTO BOOT SEL
POWER INDICATOR AND USER LEDs
USB
CAN
ALTERNATE PART: APM32F405RGT6 - C5290473 CKS32F405RGT6 - C5185730 GD32F405RGT6 - C99031
RESET BUTTON
CHAINBUS I2C
USER BUTTON
BULK
REV A. NC
CRYSTAL RESONATORS

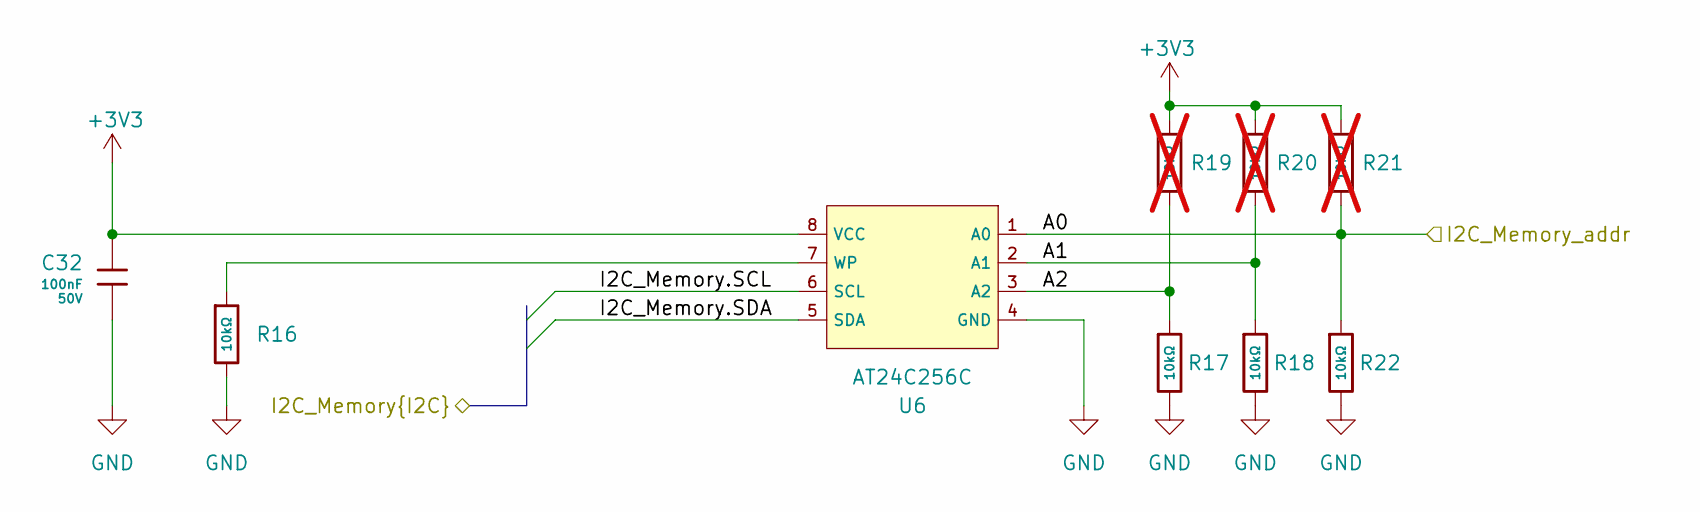
[picture p22: schematic QSPI_FLASH.kicad_sch, QSPI flash]

Parts:
C32: 100nF; C_0402; Voltage Rated 50V; Tolerance ±10%; Part CL05B104KB54PNC; LCSC C307331
R16, R17, R18, R22: 10kΩ; R_0402; Overload Voltage (Max) 50V; Tolerance ±1%; Part 0402WGF1002TCE; LCSC C25744
R19, R20, R21: 10kΩ; R_0402; Overload Voltage (Max) 50V; Tolerance ±1%; Part 0402WGF1002TCE; LCSC C25744; not fitted
U6: AT24C256C; SOIC-8_L4.9-W3.9-P1.27-LS6.0-BL; Supply Voltage 1.7V~5.5V; Part AT24C256C-SSHL-T; LCSC C6482

Connections:
+3V3: C32.1, R19.1, R20.1, R21.1, U6.8 (VCC); also elsewhere on the board
/Interboard_connector/Chainbus.SCL: U6.6 (SCL); also elsewhere on the board
/Interboard_connector/Chainbus.SDA: U6.5 (SDA); also elsewhere on the board
/MCU/I2C_Memory_addr: R21.2, R22.1, U6.1 (A0); also elsewhere on the board
/QSPI_FLASH/A1: R18.1, R20.2, U6.2 (A1)
/QSPI_FLASH/A2: R17.1, R19.2, U6.3 (A2)
GND: C32.2, R16.2, R17.2, R18.2, R22.2, U6.4 (GND); also elsewhere on the board
unnamed: R16.1, U6.7 (WP)

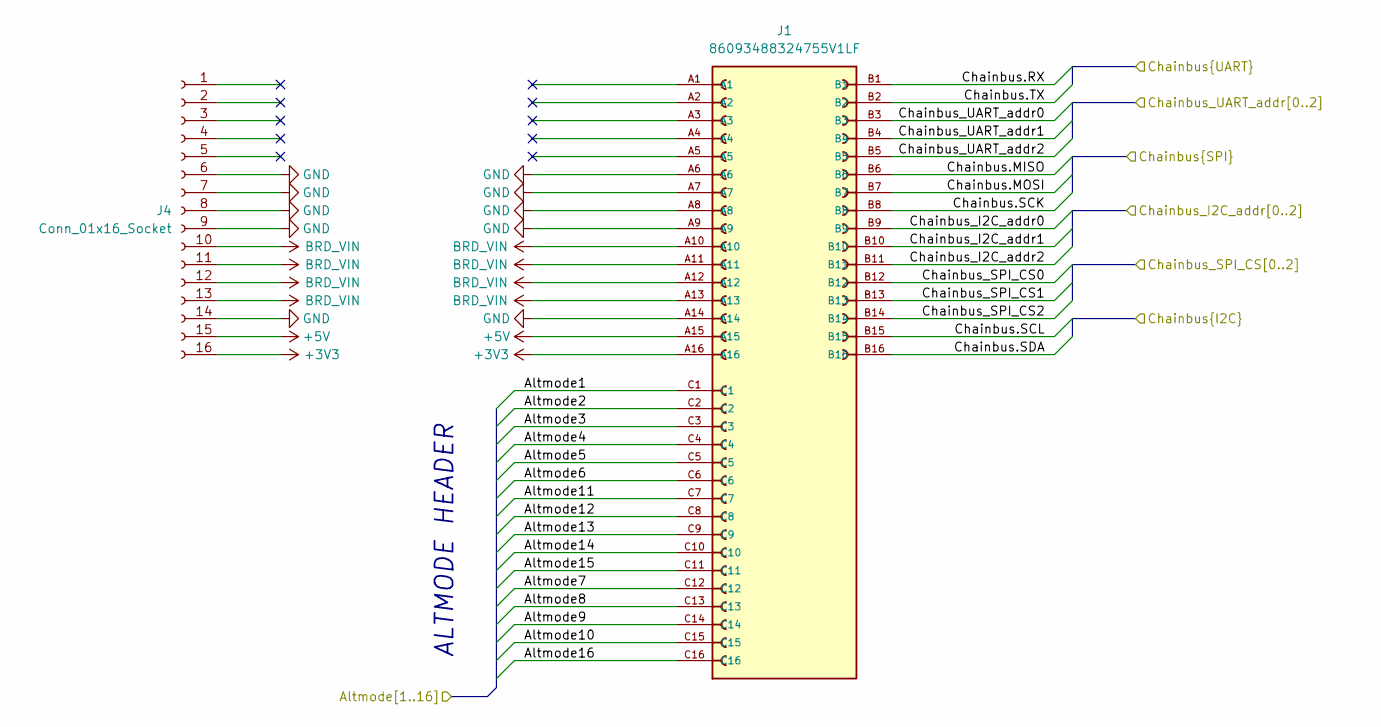
[picture p23: schematic Interboard_connector.kicad_sch, MMS interboard]

Parts:
J1: 86093488324755V1LF; AMPHENOL_86093488324755V1LF; PARTREV C; LCSC C5173373
J4: Conn_01x16_Socket; PinSocket_1x16_P2.54mm_Vertical

Connections:
+3V3: J1.A16, J4.16; also elsewhere on the board
+5V: J1.A15, J4.15; also elsewhere on the board
/Interboard_connector/Altmode1: J1.C1; also elsewhere on the board
/Interboard_connector/Altmode2: J1.C2; also elsewhere on the board
/Interboard_connector/Altmode3: J1.C3; also elsewhere on the board
/Interboard_connector/Altmode4: J1.C4; also elsewhere on the board
/Interboard_connector/Altmode5: J1.C5; also elsewhere on the board
/Interboard_connector/Altmode6: J1.C6; also elsewhere on the board
/Interboard_connector/Altmode7: J1.C12; also elsewhere on the board
/Interboard_connector/Altmode8: J1.C13; also elsewhere on the board
/Interboard_connector/Altmode9: J1.C14; also elsewhere on the board
/Interboard_connector/Altmode10: J1.C15; also elsewhere on the board
/Interboard_connector/Altmode11: J1.C7; also elsewhere on the board
/Interboard_connector/Altmode12: J1.C8; also elsewhere on the board
/Interboard_connector/Altmode13: J1.C9; also elsewhere on the board
/Interboard_connector/Altmode14: J1.C10; also elsewhere on the board
/Interboard_connector/Altmode15: J1.C11; also elsewhere on the board
/Interboard_connector/Altmode16: J1.C16; also elsewhere on the board
/Interboard_connector/Chainbus.MISO: J1.B6; also elsewhere on the board
/Interboard_connector/Chainbus.MOSI: J1.B7; also elsewhere on the board
/Interboard_connector/Chainbus.RX: J1.B1; also elsewhere on the board
/Interboard_connector/Chainbus.SCK: J1.B8; also elsewhere on the board
/Interboard_connector/Chainbus.SCL: J1.B15; also elsewhere on the board
/Interboard_connector/Chainbus.SDA: J1.B16; also elsewhere on the board
/Interboard_connector/Chainbus.TX: J1.B2; also elsewhere on the board
/Interboard_connector/Chainbus_I2C_addr0: J1.B9; also elsewhere on the board
/Interboard_connector/Chainbus_I2C_addr1: J1.B10; also elsewhere on the board
/Interboard_connector/Chainbus_I2C_addr2: J1.B11; also elsewhere on the board
/Interboard_connector/Chainbus_SPI_CS0: J1.B12; also elsewhere on the board
/Interboard_connector/Chainbus_SPI_CS1: J1.B13; also elsewhere on the board
/Interboard_connector/Chainbus_SPI_CS2: J1.B14; also elsewhere on the board
/Interboard_connector/Chainbus_UART_addr0: J1.B3; also elsewhere on the board
/Interboard_connector/Chainbus_UART_addr1: J1.B4; also elsewhere on the board
/Interboard_connector/Chainbus_UART_addr2: J1.B5; also elsewhere on the board
BRD_VIN: J1.A10, J1.A11, J1.A12, J1.A13, J4.10, J4.11, J4.12, J4.13; also elsewhere on the board
GND: J1.A6, J1.A7, J1.A8, J1.A9, J1.A14, J4.6, J4.7, J4.8, J4.9, J4.14; also elsewhere on the board

Notes on the sheet:
ALTMODE HEADER

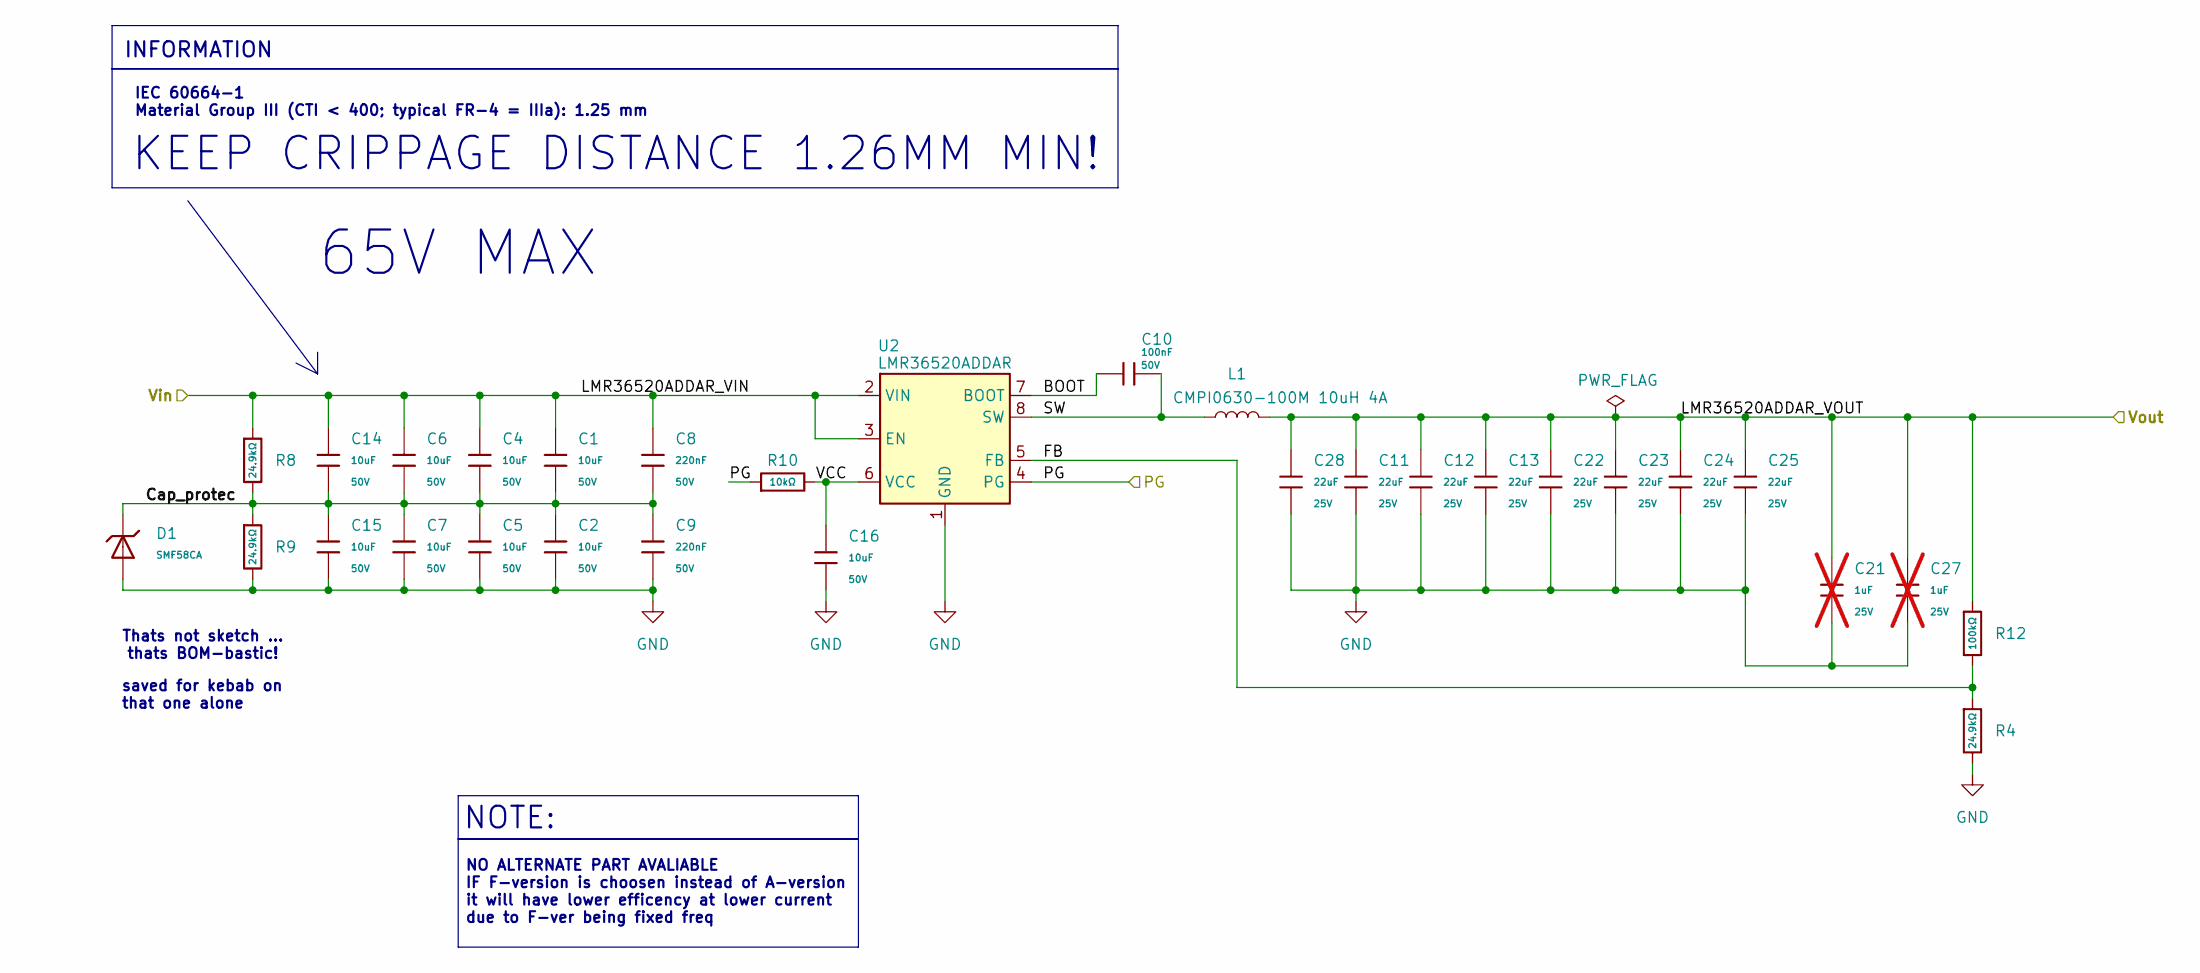
[picture p24: schematic LMR36520ADDAR.kicad_sch]

Parts:
C1, C2, C4, C5, C6, C7, C14, C15, C16: 10uF; C_0805; Voltage Rated 50V; Tolerance ±10%; Part GRM21BR61H106KE43L; LCSC C440198
C8, C9: 220nF; C_0805; Voltage Rated 50V; Tolerance ±10%; Part CL21B224KBFNNNE; LCSC C5378
C10: 100nF; C_0402; Voltage Rated 50V; Tolerance ±10%; Part CL05B104KB54PNC; LCSC C307331
C11, C12, C13, C22, C23, C24, C25, C28: 22uF; C_0805; Voltage Rated 25V; Tolerance ±20%; Part CL21A226MAQNNNE; LCSC C45783
C21, C27: 1uF; C_0402; Voltage Rated 25V; Tolerance ±10%; Part CL05A105KA5NQNC; LCSC C52923; not fitted
D1: SMF58CA; D_SOD-123FL; Clamping Voltage 93.6V; Voltage - Breakdown 71.2V; Part SMF58CA; LCSC C42371753
L1: CMPI0630-100M 10uH 4A; L_TechFuse_SL0620; LCSC C917354
R4, R8, R9: 24.9kΩ; R_0402; Overload Voltage (Max) 50V; Tolerance ±1%; Part 0402WGF2402TCE; LCSC C25874
R10: 10kΩ; R_0402; Overload Voltage (Max) 50V; Tolerance ±1%; Part 0402WGF1002TCE; LCSC C25744
R12: 100kΩ; R_0603; Overload Voltage (Max) 75V; Tolerance ±1%; Part 0603WAF1003T5E; LCSC C25803
U2: LMR36520ADDAR; Texas_HSOP-8-1EP_3.9x4.9mm_P1.27mm_ThermalVias; LCSC C2879422

Connections:
/VRM/LMR36520ADDAR/BOOT: C10.1, U2.7 (BOOT)
/VRM/LMR36520ADDAR/Cap_protec: C1.2, C2.1, C4.2, C5.1, C6.2, C7.1, C8.2, C9.1, C14.2, C15.1, D1.1, R8.2, R9.1
/VRM/LMR36520ADDAR/FB: R4.1, R12.2, U2.5 (FB)
/VRM/LMR36520ADDAR/LMR36520ADDAR_VOUT: C11.1, C12.1, C13.1, C21.1, C22.1, C23.1, C24.1, C25.1, C27.1, C28.1, L1.2, R12.1; also elsewhere on the board
/VRM/LMR36520ADDAR/PG: R10.1, U2.4 (PG)
/VRM/LMR36520ADDAR/SW: C10.2, L1.1, U2.8 (SW)
/VRM/LMR36520ADDAR/VCC: C16.1, R10.2, U2.6 (VCC)
BRD_VIN: C1.1, C4.1, C6.1, C8.1, C14.1, R8.1, U2.2 (VIN), U2.3 (EN); also elsewhere on the board
GND: C2.2, C5.2, C7.2, C9.2, C11.2, C12.2, C13.2, C15.2, C16.2, C21.2, C22.2, C23.2, C24.2, C25.2, C27.2, C28.2, D1.2, R4.2, R9.2, U2.1 (GND), U2.9 (GND); also elsewhere on the board

Notes on the sheet:
65V MAX
NO ALTERNATE PART AVALIABLE IF F-version is choosen instead of A-version it will have lower efficency at lower current due to F-ver being fixed freq
NOTE:
INFORMATION
KEEP CRIPPAGE DISTANCE 1.26MM MIN!
IEC 60664-1 Material Group III (CTI < 400; typical FR-4 = IIIa): 1.25 mm
Thats not sketch ... thats BOM-bastic!
saved for kebab on that one alone

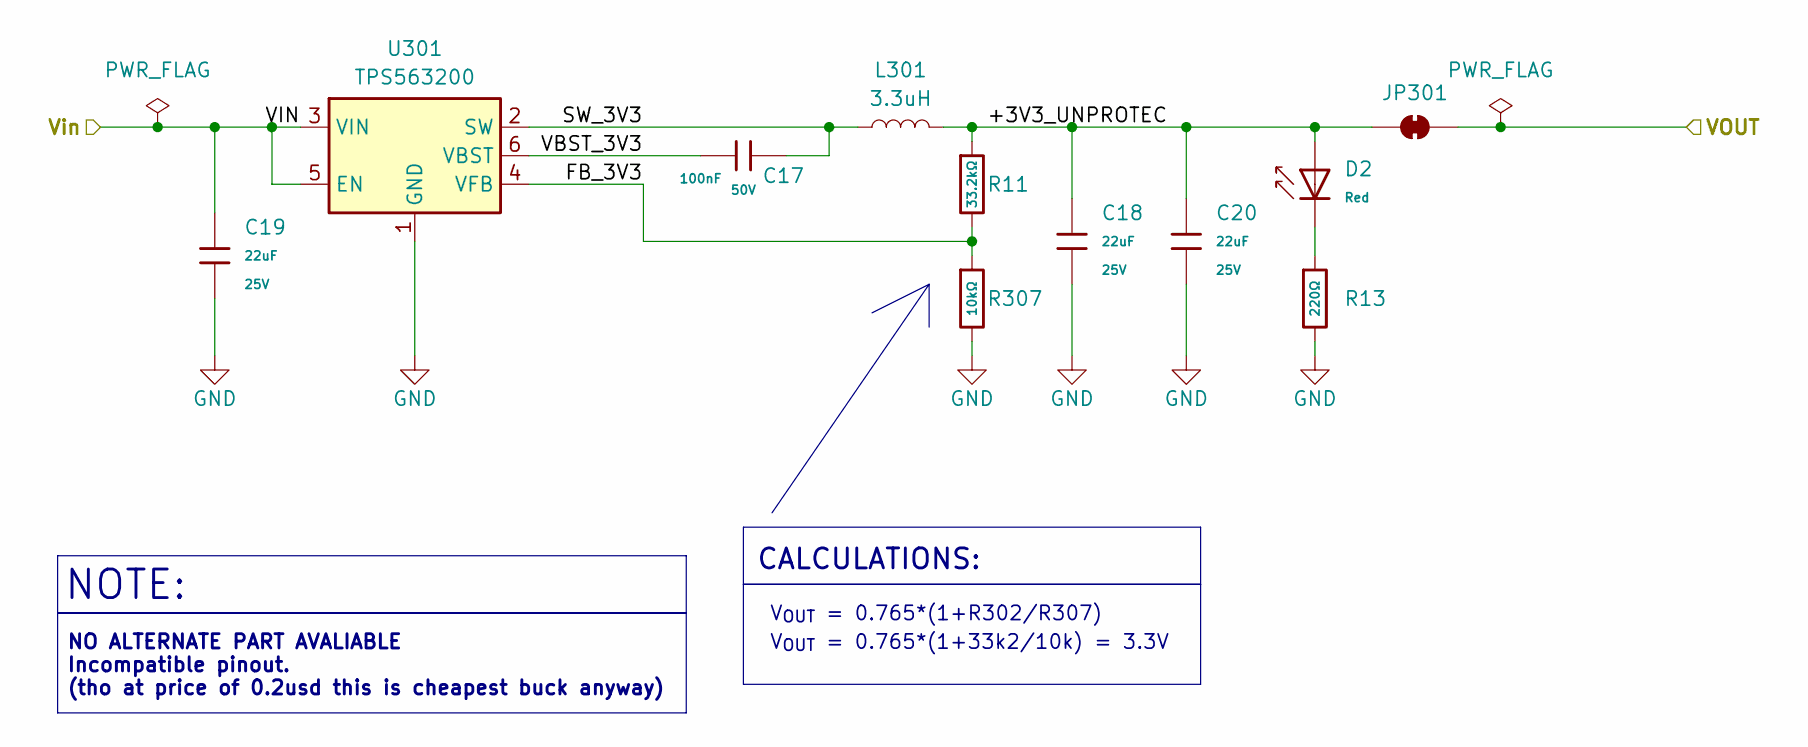
[picture p25: schematic TPS563200.kicad_sch]

Parts:
C17: 100nF; C_0402; Voltage Rated 50V; Tolerance ±10%; Part CL05B104KB54PNC; LCSC C307331
C18, C19, C20: 22uF; C_0805; Voltage Rated 25V; Tolerance ±20%; Part CL21A226MAQNNNE; LCSC C45783
D2: Red; D_0603; Part KT-0603R; LCSC C2286
JP301: SolderJumper_2_Bridged; SolderJumper-2_P1.3mm_Open_TrianglePad1.0x1.5mm
L301: 3.3uH; L_Changjiang_FXL0420; LCSC C167207
R11: 33.2kΩ; R_0402; Overload Voltage (Max) 50V; Tolerance ±1%; Part 0402WGF1002TCE; LCSC C122548
R13: 220Ω; R_0402; Overload Voltage (Max) 50V; Tolerance ±1%; Part 0402WGF2200TCE; LCSC C25091
R307: 10kΩ; R_0402; Overload Voltage (Max) 50V; Tolerance ±1%; Part 0402WGF1002TCE; LCSC C25744
U301: TPS563200; SOT-23-6; LCSC C116592

Connections:
+3V3: JP301.2 (B); also elsewhere on the board
+5V: C19.1, U301.3 (VIN), U301.5 (EN); also elsewhere on the board
/VRM/TPS563201/+3V3_UNPROTEC: C18.1, C20.1, D2.2, JP301.1 (A), L301.2, R11.1
/VRM/TPS563201/FB_3V3: R11.2, R307.1, U301.4 (VFB)
/VRM/TPS563201/SW_3V3: C17.1, L301.1, U301.2 (SW)
/VRM/TPS563201/VBST_3V3: C17.2, U301.6 (VBST)
GND: C18.2, C19.2, C20.2, R13.2, R307.2, U301.1 (GND); also elsewhere on the board
unnamed: D2.1, R13.1

Notes on the sheet:
CALCULATIONS:
NO ALTERNATE PART AVALIABLE Incompatible pinout. (tho at price of 0.2usd this is cheapest buck anyway)
NOTE:
V_{OUT} = 0.765*(1+33k2/10k) = 3.3V
V_{OUT} = 0.765*(1+R302/R307)

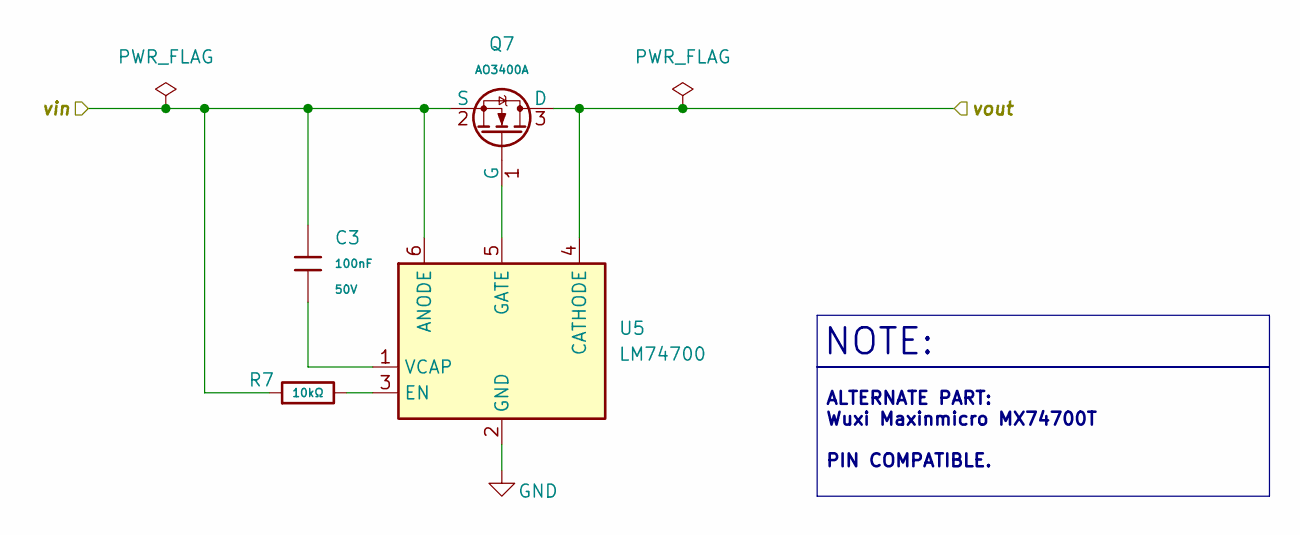
[picture p26: schematic LMR74700.kicad_sch]

Parts:
C3: 100nF; C_0402; Voltage Rated 50V; Tolerance ±10%; Part CL05B104KB54PNC; LCSC C307331
Q7: AO3400A; Q_SOT-23; Part AO3400A; LCSC C20917
R7: 10kΩ; R_0402; Overload Voltage (Max) 50V; Tolerance ±1%; Part 0402WGF1002TCE; LCSC C25744
U5: LM74700; SOT-23-6; LCSC C2941042

Connections:
+5V: Q7.3 (D), U5.4 (CATHODE); also elsewhere on the board
/VRM/LMR36520ADDAR/LMR36520ADDAR_VOUT: C3.2, Q7.2 (S), R7.1, U5.6 (ANODE); also elsewhere on the board
GND: U5.2 (GND); also elsewhere on the board
unnamed: Q7.1 (G), U5.5 (GATE)
unnamed: R7.2, U5.3 (EN)
unnamed: C3.1, U5.1 (VCAP)

Notes on the sheet:
NOTE:
ALTERNATE PART: Wuxi Maxinmicro MX74700T PIN COMPATIBLE.

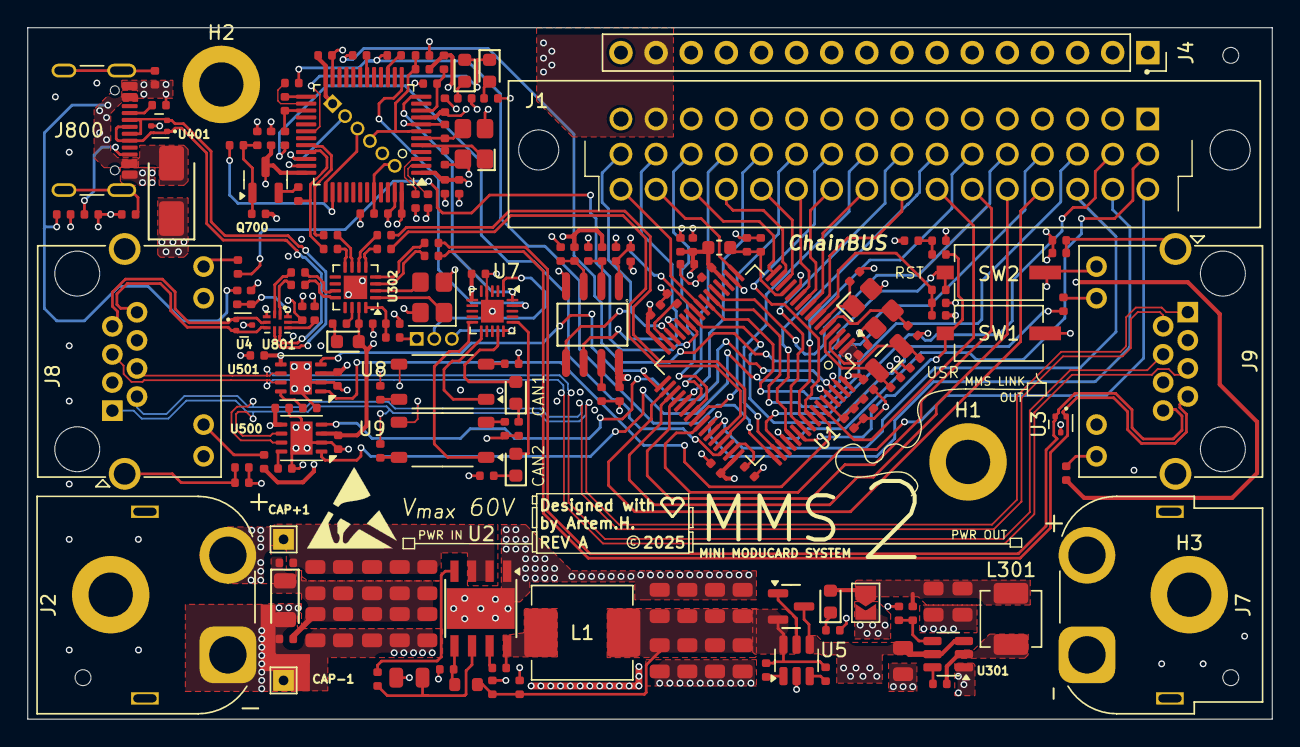
[picture p27: board MMS2.kicad_pcb from above]

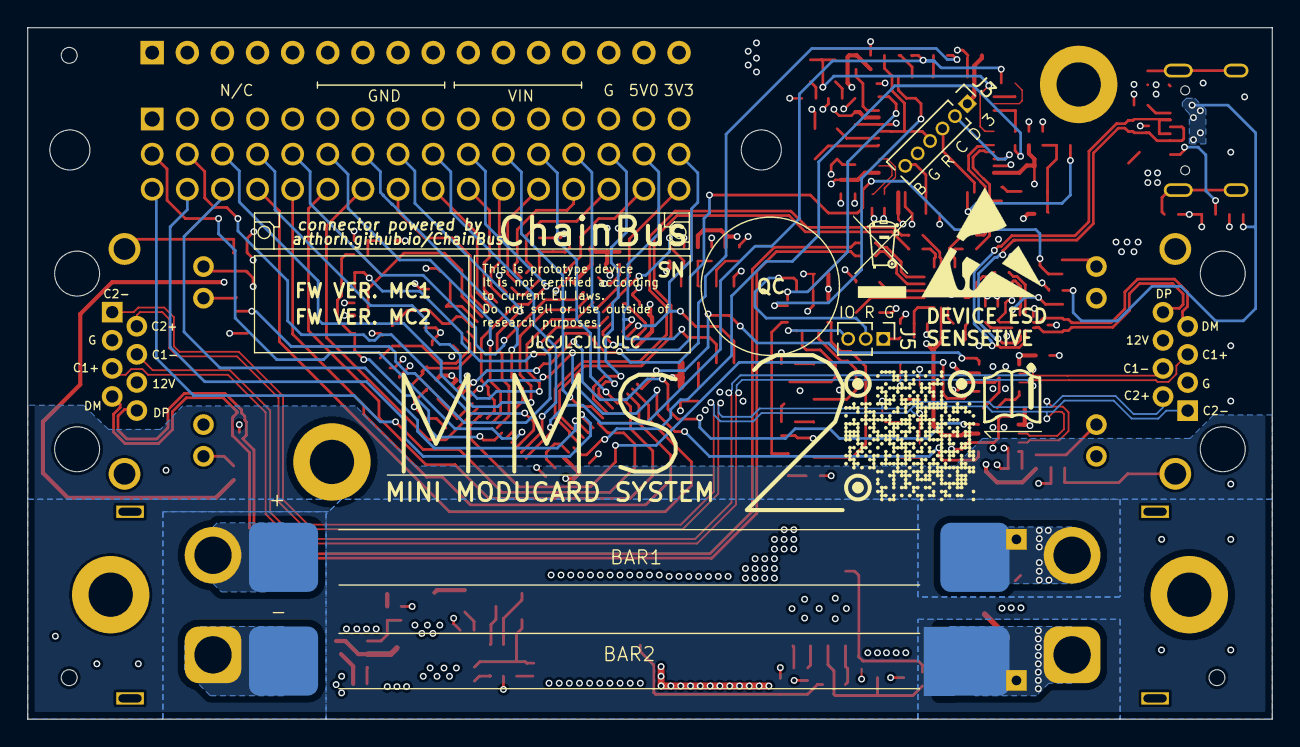
[picture p28: board MMS2.kicad_pcb from below]

Board: 4 copper layers, 90.0 x 50.0 mm, 192 parts (5 on the bottom side), 154 nets.
