ArthorH/MMS2-F405/(commit log)

2025-09-15 F405 change compleate
    [AMS1117.kicad_sch, Buck converter.kicad_sch, CAN terminator.kicad_sch, CAN_TR.kicad_sch, Connector Panel 1.kicad_sch, Connector panel 2.kicad_sch, Connector.kicad_sch, Interboard_connector.kicad_sch]
2025-09-18 Component placement done
    [CH32V003.kicad_sch, Interboard_connector.kicad_sch, MCU.kicad_sch, MMS2.kicad_pcb, MMS2.kicad_sch, TPS563200.kicad_sch]
2025-09-22 processor connection done
    [Interboard_connector.kicad_sch, MCU.kicad_sch, MMS2.kicad_pcb, MMS2.kicad_sch]
2025-09-22 add specification
    [Chainbus-Pinout-Specification.xlsx]
2025-09-25 silk job, signal ratnest done
    [CH32V003.kicad_sch, Interboard_connector.kicad_sch, MCU.kicad_sch, MMS2.kicad_pcb, MMS2.kicad_sch]
2025-09-26 change can term add usr led
    [CAN terminator.kicad_sch, CH32V003.kicad_sch, MCU.kicad_sch, MMS2.kicad_pcb, MMS2.kicad_sch, MMS_CONNECTOR.kicad_sch]
2025-09-27 DRC PASS, preparing bom for production
    [LMR36520ADDAR.kicad_sch, MCU.kicad_sch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]
2025-09-28 bom done
    [CAN terminator.kicad_sch, CAN_TR.kicad_sch, CH32V003.kicad_sch, Interboard_connector.kicad_sch, LMR36520ADDAR.kicad_sch, LMR74700.kicad_sch, MCU.kicad_sch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]
2025-09-29 REV A production ready
    [MMS2-CuBottom.gbr, MMS2-CuIn1.gbr, MMS2-CuIn2.gbr, MMS2-CuTop.gbr, MMS2-EdgeCuts.gbr, MMS2-MaskBottom.gbr, MMS2-MaskTop.gbr, MMS2-NPTH.drl]
2025-09-29 Generate production files
    [MMS2-CuBottom.gbr, MMS2-CuIn1.gbr, MMS2-CuIn2.gbr, MMS2-CuTop.gbr, MMS2-EdgeCuts.gbr, MMS2-MaskBottom.gbr, MMS2-MaskTop.gbr, MMS2-NPTH.drl]
