ArthorH/MMS2-F405/(notices)

Notices in the files:
parts and their libraries:
License: Apache-2.0
